XiaoKChen/Work-Normal-Corperation-Altium/README.md

# Work-Normal-Cooperation-Altium
Work-Normal-Cooperation-Altium
