XiaoKChen/Work-Normal-Corperation-Altium/Board/infineon-cy8ckit-062s2-ai-psoc-6-ai-evaluation-board-hardware-pcbdesigndata-en/CY8CKIT-062S2-AI PSoC 6 AI Evaluation Kit PCBA BoM.xlsm

Sheet: Revision History
Revision | Date | Description | Prepared By | Approved By
0.01 | 2023-11-23 | Initial Revision BOM for ordering | MRRS | Vamsi
0.02 | 2023-12-07 | Final Revision BOM for ordering | MRRS | Vamsi
1 | 2023-12-12 | Initial release of Rev01 BoM | MRRS | Vamsi
2 | 2024-02-07 | REV02 design BOM | MRRS | Vamsi
2.1 | 2024-03-04 | REV02 design generated BOM | MRRS | Vamsi
3 | 2024-03-12 | REV03 design BOM | MRRS | Vamsi
 |  |  |  |  | a

Sheet: PCBA BOM
 |  |  |  |  | TITLE | PSoC™ 6 AI Evaluation Board
 |  |  |  |  | PCBA Number & Revision | 121-60699-01 | Rev 03
 |  |  |  |  | Schematics Number & Revision | 630-60699-01 | Rev 03
 |  |  |  |  | DATE | 2024-04-12
 |  |  |  |  | BOM REVISION | Rev 03
 |  |  |  |  | ROHS Compliance | Required
 |  |  |  |  | UL Compliance | Required
# | IFX Part # | Qty | Reference | Value | Description | Manufacturer | Mfr Part # | Alternate Manufacturer | Alternate Mfr Part #
1 | 753-60006-01 | 1 | A2 | 2450AT07A0100T | ANTENNA, CERAMIC CHIP, Single Band, 2.4GHz, SMD | Johanson | 2450AT07A0100T
2 | 510-60777-01 | 33 | C1,C4,C8,C14,C17,C19,C21,C23,C26,C28,C30,C32,C41,C43,C45,C47,C49,C50,C52,C53,C55,C57,C58,C66,C67,C68,C71,C92,C115,C116,C119,C121,C256 | 0.1uF | CAP, CER, 0.1uF, 20%, X5R, 10V, 0201 | Wurth | 885012104002
3 | 510-60422-01 | 4 | C2,C5,C247,C248 | 4.7uF | CAP, CER, 0402, 4.7uF, 20%, 10V, X5R | Murata | GRM155R61A475MEAAD
4 | 510-60877-01 | 5 | C3,C7,C12,C13,C15 | 1uF | CAP, CER, 1UF, 20%, 10V, X5R, 0402 | Wurth | 885012105012
5 | 510-60089-01 | 1 | C6 | 10nF | CAP, CER, 10nF, 10%, X7R, 50V, 0402 | Wurth | 885012205067
6 | 510-60337-01 | 14 | C9,C10,C11,C36,C38,C40,C72,C74,C76,C78,C81,C83,C87,C88 | 10uF | CAP, CER, 10uF, 20%, X5R, 10V, 0402 | Samsung | CL05A106MP8NUB8
7 | 510-61118-01 | 31 | C16,C18,C20,C22,C24,C25,C27,C29,C31,C33,C34,C37,C39,C42,C44,C46,C48,C51,C54,C56,C73,C75,C77,C79,C82,C84,C85,C86,C89,C93,C249 | 1uF | CAP, CER, 1UF, 10V, X5R, 0201 | YAEGO | CC0201MRX5R6BB105
8 | 510-61073-01 | 1 | C35 | 4.7uF | CAP, CER, 4.7µF, ±20%, 6.3V, X5R, 0201 | Murata | GRM035R60J475ME15J
9 | 510-60833-01 | 2 | C60,C61 | 22pF | CAP, CER, 22pF, 5%, NP0, 25V, 0201 | Wurth | 885012004008
10 | 510-60782-01 | 2 | C62,C63 | 10pF | CAP, CER, 10pF, 5%, NP0, 25V, 0201 | Wurth | 885012004004
11 | 510-61137-01 | 1 | C80 | 0.47uF | CAP, CER, 0.47UF, 20%, X5R, 6.3V, 0402 | Wurth | 885012105004
12 | 510-60376-01 | 2 | C99,C245 | 2.2uF | CAP CER 2.2UF 10V X5R 0402 | Wurth | 885012105013
13 | 510-60825-01 | 2 | C246,C254 | 6.8pF | CAP CER 6.8PF 50V C0G/NP0 0402 | Johanson | 500R07S6R8BV4T
14 | 510-60250-01 | 1 | C250 | 1.2pF | CAP, CER, 1.2PF, 8%, NP0, 50V, 0402 | Johanson | 500R07S1R2BV4T
15 | 534-60141-01 | 5 | D1,D2,D3,D11,D12 | 5988A10107F | DIO, LED, 635nm, RED, 0402 | Dialight | 5988A10107F
16 | 530-60314-01 | 2 | D4,D10 | T5V0S5A-7 | DIODE, TVS, 17.3V, 15A, SOD-523 | Diodes Incorporated | T5V0S5A-7
17 | BAS3010B03WE6327HTSA1 | 2 | D5,D6 | BAS3010B03WE6327HTSA1 | DIODE SCHOTTKY 30V 1A SOD323-2 | Infineon | BAS3010B03WE6327HTSA1
18 | 534-60149-01 | 1 | D8 | LTST-C281KGKT | LED, GREEN, CLEAR, 571nm, 2V, 0402 | Lite-On Inc. | LTST-C281KGKT
19 | 530-60165-01 | 1 | D9 | ESD5V0D5-TP | DIO, TVS, UNIDIR, 5V, 18.6V, 174W, SOD-523 | MCC | ESD5V0D5-TP
20 | 520-60305-01 | 10 | FB3,FB4,FB5,FB6,FB7,FB8,FB9,FB10,FB11,FB12 | 600 OHM | IND, FERRITE BEAD, 600 OHM, 0402, 1LN | TDK | MMZ1005B601CT000
21 | 720-60675-01 | 2 | J1,J2 | 629722000214 | CONN, RCPT, USB, TYPE-C, USB2.0, 12POS, TOP MOUNT, RA, SMD | Wurth | 629722000214
22 | 720-60595-01 | 1 | J3 | 620102131822 | CONN, HDR, 1x2POS, SHROUNDED, R/A, 2MM PITCH, SMT | Wurth | 620102131822
23 | 710-60030-01 | 1 | J4 | HDR 5x2 | CONN, HDR, MALE, DUAL, 10POS, 1.27mm, GOLD, STR, SMD | Samtec | FTSH-105-01-L-DV-K-P-TR
24 | 720-60640-01 | 1 | J15 | DF40C-20DP-0.4V(51) | CONN, PLUG, DUAL, 20POS, 0.4mm, SMD, GOLD | Hirose | DF40C-20DP-0.4V(51)
25 | 720-60696-01 | 1 | J16 | 665104131822 | CONN, HEADER, R/A, 4POS, 1MM, SMD | Wurth | 665104131822
26 | 520-60318-01 | 1 | L1 | 2.2uH | IND, FIXED, SHIELDED, 2.2uH, 20%, 1.7A, 0.050 OHM, SMD | Wurth | 74404032022
27 | 520-60187-01 | 1 | L2 | 2.2uH | IND, FIXED, SHIELDED, 2.2uH, 0.5A, 0.18 OHM, 0603 | TDK | MLZ1608N2R2LT000
28 | 520-60183-01 | 1 | L3 | 2.2uH | IND, FIXED, SHIELDED, 2.2uH, 0.7A, 0.34 OHM, 0805 | Wurth | 74479774222
29 | 500-61336-01 | 7 | R1,R2,R15,R26,R55,R62,R63 | 1K | RES, 1K OHM, 1%, 1/20W, 0201 | Yageo | RC0201FR-071KL
30 | 500-61335-01 | 6 | R4,R8,R10,R11,R84,R85 | 10K | RES, 10K OHM, 1%, 1/20W, 0201 | Yageo | RC0201FR-0710KL
31 | 500-61333-01 | 4 | R5,R6,R17,R18 | 5.1K | RES, 5.1K OHM, 5%, 1/20W, 0201 | Yageo | RC0201JR-075K1L
32 | 500-61334-01 | 3 | R7,R101,R102 | 100K | RES, 100K OHM, 1%, 1/20W, 0201 | Yageo | RC0201FR-07100KL
33 | 500-61337-01 | 1 | R14 | 3.01K | RES, 3.01K OHM, 1%, 1/20W, 0201 | Yageo | RC0201FR-073K01L
34 | 500-60979-01 | 9 | R16,R19,R20,R22,R25,R34,R41,R281,R282 | 4.7K | RES, 4.7K OHM, 5%, 1/20W, 0201 | Yageo | RC0201JR-074K7L
35 | 500-61332-01 | 1 | R21 | 560K | RES, 560K OHM, 1%, 1/20W, 0201 | Yageo | RC0201FR-07560KL
36 | 500-61331-01 | 1 | R23 | 90.9K | RES, 90.9K OHM, 1%, 1/20W, 0201 | Yageo | RC0201FR-0790K9L
37 | 500-60585-01 | 14 | R27,R40,R56,R57,R59,R60,R100,R275,R277,R278,R284,R288,R289,R290 | 0 OHM | RES, Fixed, 0 OHM, JUMPER, 1A, 0402 | Yageo | RC0402JR-070RL
38 | 500-61326-01 | 1 | R28 | 49.9K | RES, 49.9K OHM, 1%, 1/20W, 0201 | Yageo | RC0201FR-0749K9L
39 | 500-61327-01 | 3 | R30,R33,R279 | 15K | RES, 15K OHM, 1%, 1/20W, 0201 | Yageo | RC0201FR-0715KL
40 | 500-61325-01 | 3 | R31,R36,R280 | 30K | RES, 30K OHM, 1%, 1/20W, 0201 | Yageo | RC0201FR-0730KL
41 | 500-61328-01 | 2 | R35,R37 | 22 OHM | RES, 22 OHM, 5%, 1/20W, 0201 | Yageo | RC0201JR-0722RL
42 | 500-61330-01 | 1 | R38 | 560 OHM | RES, 560 OHM, 5%, 1/20W, 0201 | Yageo | RC0201JR-07560RL
43 | 500-60037-01 | 3 | R39,R96,R97 | 0 OHM | RES, Fixed, 0 OHM, JUMPER, 1A, 0603 | Panasonic | ERJ-3GEY0R00V
44 | 500-60978-01 | 7 | R42,R43,R44,R45,R46,R47,R50 | 47K | RES, Fixed, 47K, 5%, 1/20W, 0201 | Yageo | RC0201JR-0747KL
45 | 500-60980-01 | 11 | R48,R49,R51,R52,R53,R54,R87,R88,R89,R90,R91 | 33 OHM | RES, Fixed, 33 OHM, 5%, 1/20W, 0201 | Yageo | RC0201JR-0733RP
46 | 500-60684-01 | 16 | R64,R65,R72,R74,R80,R81,R86,R285,R287,R291,R292,R293,R294,R295,R296,R299 | 0 OHM | RES, Fixed, 0 OHM, JUMPER, 0.5A, 0201 | Yageo | RC0201JR-070RL
47 | 500-61324-01 | 2 | R71,R79 | 100 OHM | RES, FIXED, 100 OHM, 5%, 1/20W, 0201 | Yageo | RC0201JR-07100RL
48 | 500-60730-01 | 1 | R83 | 150 OHM | RES, Fixed, 150 OHM, 1%, 1/10W, 0402 | Panasonic | ERJ-2RKF1500X
49 | 770-60161-01 | 3 | SW1,SW2,SW3 | 435171014816 | SW, Tactile Switch SPST-NO, TOP Actuated SMD | Wurth | 435171014816
50 | CY8C624ABZI-S2D44 | 1 | U1 | CY8C624ABZI-S2D44 | IC, CYPRESS, MCU, PSoC 62-S2, Dual Core, 150/100MHz, 1.71V-3.6V, 124-BGA | Cypress | CY8C624ABZI-S2D44
51 | CY8C5868LTI-LP039 | 1 | U2 | CY8C5868LTI-LP039 | IC, CYPRESS, MCU, PSoC 5LP, 32 Bit MCU, 67MHz, 1.8V-5.5V, 68-QFN | Cypress | CY8C5868LTI-LP039
52 | DPS368XTSA1 | 1 | U3 | DPS368XTSA1 | IC, INFINEON, SENSOR, 17.4PSIG, 24BIT, 8VLGA | infineon | DPS368XTSA1
53 | IM72D128V01XTMA1 | 2 | U4,U5 | IM72D128V01XTMA1 | IC, INFINEON, DIGITAL MEMS MICROPHONE, 1.62 to 3.6V, -36dB, SMD | Infineon | IM72D128V01XTMA1
54 | BGT60TR13CE6327XUMA1 | 1 | U6 | BGT60TR13CE6327XUMA1 | IC, INFINEON, Radar Sensor, 60GHz, 1Tx 3Rx Antennas in Package, PG-VF2BGA40-1 | Infineon | BGT60TR13CE6327XUMA1
55 | S25HS512TFANHI010 | 1 | U7 | S25HS512TFANHI010 | IC, INFINEON, QSPI Flash, 1.8V IO, 166Mhz, 512Mb, WSON-8 | infineon | S25HS512TFANHI010
56 | 471-60048-01 | 1 | U8 | BQ24074RGTT | IC, REG, Battery Charger, Single Cell Li-Ion, 1.5A, 16VQFN | TI | BQ24074RGTT
57 | ESD5V3U2U-03F | 2 | U9,U16 | ESD5V3U2U-03F | DIO, INFINEON, ESD Protection, 5.3V, 2CH, +/-20KV, SOT-723 | IFX | ESD5V3U2U-03F
58 | 470-60022-01 | 1 | U11 | RT6150BGQW | IC, REG, BUCK BST, ADJ, 800MA, 10WDFN | Richtek | RT6150BGQW
59 | 540-60028-01 | 1 | U15 | 80 MHz | OSC, 80MHz, 50PPM, 1.6/3.63V, SMD | KYOCERA | KC2016K80.0000C1GE00
60 | 460-60009-01 | 1 | U17 | LBEE5KL1YN-814 | IC, Module, CYW43439, 2.4GHz WLAN + Bluetooth, SMD | Murata | LBEE5KL1YN-814
61 | 415-00031-01 | 1 | U18 | BMI270 | IC, IMU, ACCELEROMETER/GYRO, 6-AXIS, I2C/SPI, 14-LGA | Bosch | BMI270
62 | 415-00032-01 | 1 | U19 | BMM350 | IC, SENSOR, MAGNETOMETER, MAGNETORESISTIVE, 3-AXIS, I2C/I3C, 9-WLCSP | Bosch | BMM350
63 | 471-60050-01 | 1 | U20 | NCP115AMX330TBG | IC, REG, LINEAR, 3.3V, 300mA, 4XDFN | ONSEMI | NCP115AMX330TBG
64 | 471-60051-01 | 1 | U21 | NCP115AMX180TBG | IC, REG, LINEAR, 1.8.V, 300mA, 4XDFN | ONSEMI | NCP115AMX180TBG
65 | 542-60119-01 | 1 | Y1 | 32.768KHz | XTAL, 32.768kHz, 20ppm, 12.5pF, SMD | WURTH | 830065253
66 | 542-60117-01 | 1 | Y2 | 24MHZ | CRYSTAL, 24MHZ, ±10ppm, 10PF, SMD | CTS | 402F2401XIAR
67 | 540-60011-01 | 1 | Y3 | SIT1533AI-H4-DCC-32.768E | OSC, MEMS, 32.768kHz, 20ppm, LVCMOS, SMD | SiTIME | SIT1533AI-H4-DCC-32.768E
ACCESSORIES
68 | 121-60699-01 | 1 | ACC1 | 121-60699-01 | ASSY, PCBA, CY8CKIT-062S2-AI - PSoC6 AI Evluation board | Cypress Approved CM | 121-60699-01
69 | 600-60699-01 | 1 | ACC2 | 600-60699-01 | PCB, BARE, CY8CKIT-062S2-AI - PSoC6 AI Evluation board | Cypress Approved CM | 600-60699-01
70 | 610-60699-01 | 1 | ACC3 | 610-60699-01 | DRW, FABRICATION DRAWING, CY8CKIT-062S2-AI - PSoC6 AI Evluation board | -NA- | 610-60699-01
71 | 620-60699-01 | 1 | ACC4 | 620-60699-01 | DRW, ASSEMBLY DRAWING, CY8CKIT-062S2-AI - PSoC6 AI Evluation board | -NA- | 620-60699-01
72 | 630-60699-01 | 1 | ACC5 | 630-60699-01 | DRW, SCHEMATIC DRAWING, CY8CKIT-062S2-AI - PSoC6 AI Evluation board | -NA- | 630-60699-01
No Load
73 | 510-60512-02 | 1 | C253 | 150pF | CAP, CER, 150pF, 5%, C0G/NP0, 50V, 0402 | Samsung | CL05C151JB5NNNC
74 | 510-60825-01 | 1 | C255 | 6.8pF | CAP CER 6.8PF 50V C0G/NP0 0402 | Johanson | 500R07S6R8BV4T
75 | 720-60585-01 | 1 | J5 | A-1JB | CONN, UMC, JACK, STR, 50 OHM, SMD | Amphenol | A-1JB
76 | 710-60054-01 | 1 | J17 | PRPC006SFAN-RC | CONN, HEADER, VERT, 6POS, 2.54MM, TH | Sullins | PRPC006SFAN-RC
77 | 710-60142-01 | 1 | J18 | PRPC009SFAN-RC | CONN, HEADER, VERT, 9POS, 2.54MM, TH | Sullins | PRPC009SFAN-RC
78 | 520-60020-01 | 1 | L4 | 6.8nH | IND, FIXED, UNSHIELDED, 6.8nH, 0.25A, 0.32 OHM, 0402 | Johanson | L-07C6N8JV6T
79 | 500-61335-01 | 3 | R3,R9,R12 | 10K | RES, 10K OHM, 1%, 1/20W, 0201 | Yageo | RC0201FR-0710KL
80 | 500-61080-01 | 1 | R13 | 10K | RES, Fixed, 10K, 1%, 1/16W, 0402 | Yageo | RT0402FRE0710KL
81 | 500-60979-01 | 1 | R24 | 4.7K | RES, 4.7K OHM, 5%, 1/20W, 0201 | Yageo | RC0201JR-074K7L
82 | 500-61326-01 | 1 | R29 | 49.9K | RES, 49.9K OHM, 1%, 1/20W, 0201 | Yageo | RC0201FR-0749K9L
83 | 500-60978-01 | 1 | R58 | 47K | RES, Fixed, 47K, 5%, 1/20W, 0201 | Yageo | RC0201JR-0747KL
84 | 500-61334-01 | 1 | R66 | 100K | RES, 100K OHM, 1%, 1/20W, 0201 | Yageo | RC0201FR-07100KL
85 | 500-60684-01 | 4 | R73,R82,R283,R286 | 0 OHM | RES, Fixed, 0 OHM, JUMPER, 0.5A, 0201 | Yageo | RC0201JR-070RL
86 | 500-61325-01 | 2 | R297,R298 | 30K | RES, 30K OHM, 1%, 1/20W, 0201 | Yageo | RC0201FR-0730KL
87 | NA | 26 | TP1,TP2,TP3,TP4,TP5,TP6,TP7,TP8,TP9,TP10,TP11,TP12,TP16,TP17,TP19,TP23,TP24,TP26,TP27,TP28,TP29,TP30,TP31,TP32,TP33,TP34 | TP_SMD | TestPoint, PCB, Circle, 1mm, SMD | NA | NA
 |  |  |  |  |  |  |  |  |  | DNI
 |  |  |  |  |  |  |  |  |  | DNI
 |  |  |  |  |  |  |  |  |  | DNI
 |  |  |  |  |  |  |  |  |  | DNI
 |  |  |  |  |  |  |  |  |  | DNI
 |  |  |  |  |  |  |  |  |  | DNI
 |  |  |  |  |  |  |  |  |  | DNI
 |  |  |  |  |  |  |  |  |  | DNI
 |  |  |  |  |  |  |  |  |  | DNI
 |  |  |  |  |  |  |  |  |  | DNI
 |  |  |  |  |  |  |  |  |  | DNI
 |  |  |  |  |  |  |  |  |  | DNI
 |  |  |  |  |  |  |  |  |  | DNI
 |  |  |  |  |  |  |  |  |  | DNI
 |  |  |  |  |  |  |  |  |  | DNI
