XiaoKChen/Work-Normal-Corperation-Altium/Components/LIB_ADS7951SRGER/ADS7951SRGER/3D/ADS7951SRGER.stp

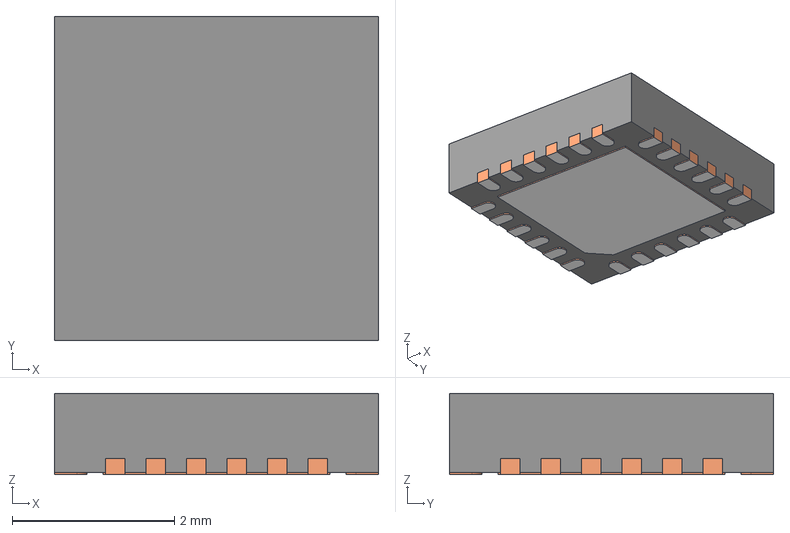
[picture p1: CAD file, 2025-12-14]
Components/LIB_ADS7951SRGER/ADS7951SRGER/3D/ADS7951SRGER.stp
4.00 x 4.00 x 1.00 mm
BODY-QFN
FRAME-RGE0024F
PIN1-ID
