XiaoKChen/Work-Normal-Corperation-Altium/Components/LIB_APHHS1005LQBC_D-V/APHHS1005LQBC_D-V/3D/APHHS1005LQBC_D-V.stp

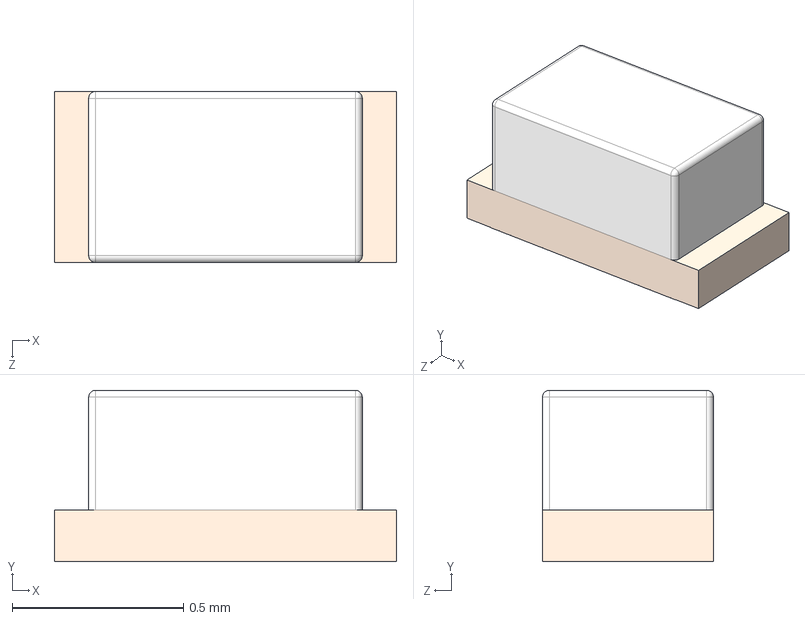
[picture p2: CAD file, 2025-12-14]
Components/LIB_APHHS1005LQBC_D-V/APHHS1005LQBC_D-V/3D/APHHS1005LQBC_D-V.stp
1.00 x 0.501 x 0.5 mm
