XiaoKChen/Work-Normal-Corperation-Altium/Components/LIB_CY8C5868LTI-LP039/CY8C5868LTI-LP039/3D/CY8C5868LTI-LP039.stp

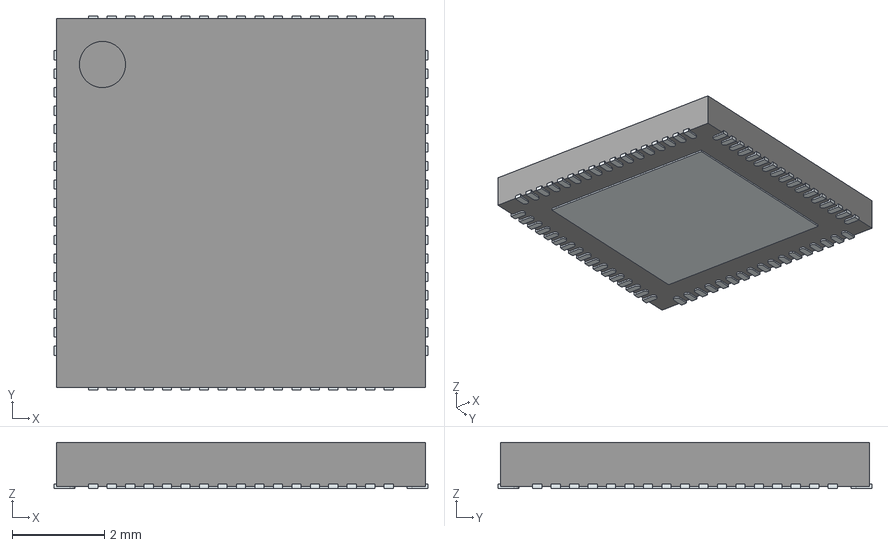
[picture p3: CAD file, 2025-12-14]
Components/LIB_CY8C5868LTI-LP039/CY8C5868LTI-LP039/3D/CY8C5868LTI-LP039.stp
8.10 x 8.10 x 1.00 mm
ThermalPin
PinsArrayLR
PinsArrayTB
