XiaoKChen/Work-Normal-Corperation-Altium/Components/LIB_ERA-2VEB1002X/ERA-2VEB1002X/3D/ERA-2VEB1002X.stp

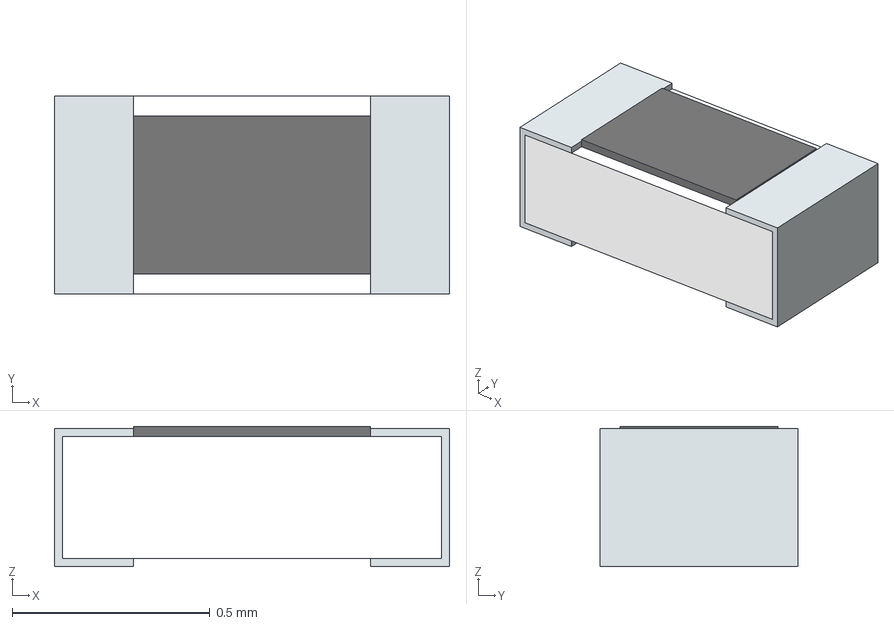
[picture p4: CAD file, 2025-12-14]
Components/LIB_ERA-2VEB1002X/ERA-2VEB1002X/3D/ERA-2VEB1002X.stp
1.00 x 0.5 x 0.355 mm
solidBody
Terminal
solidTop
