XiaoKChen/Work-Normal-Corperation-Altium/Components/LIB_ESD2CAN24DBZRQ1/ESD2CAN24DBZRQ1/3D/ESD2CAN24DBZRQ1.stp

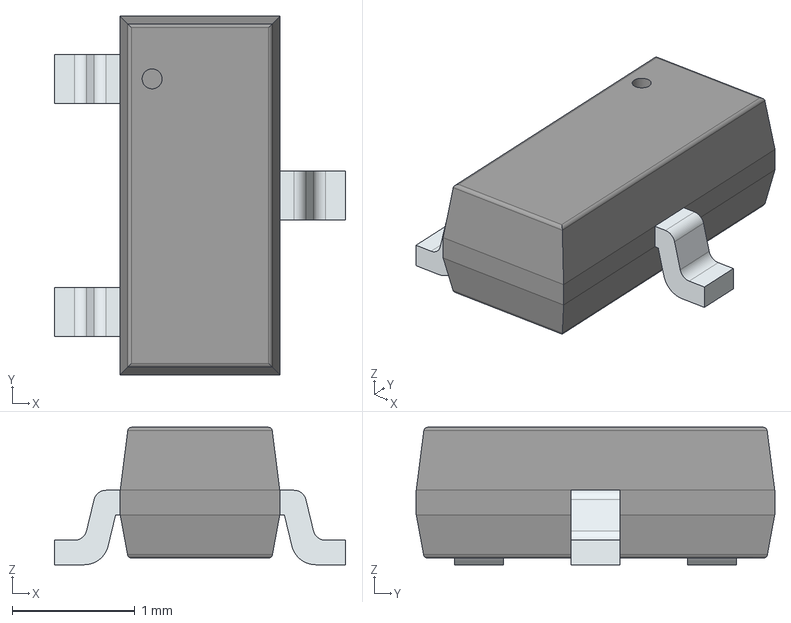
[picture p5: CAD file, 2025-12-14]
Components/LIB_ESD2CAN24DBZRQ1/ESD2CAN24DBZRQ1/3D/ESD2CAN24DBZRQ1.stp
2.37 x 2.92 x 1.12 mm
PinsArrayL
FilletPinR
