XiaoKChen/Work-Normal-Corperation-Altium/Components/LIB_FTSH-105-01-L-DV-K-P-TR/FTSH-105-01-L-DV-K-P-TR/3D/FTSH-105-01-L-DV-K-P-TR.stp

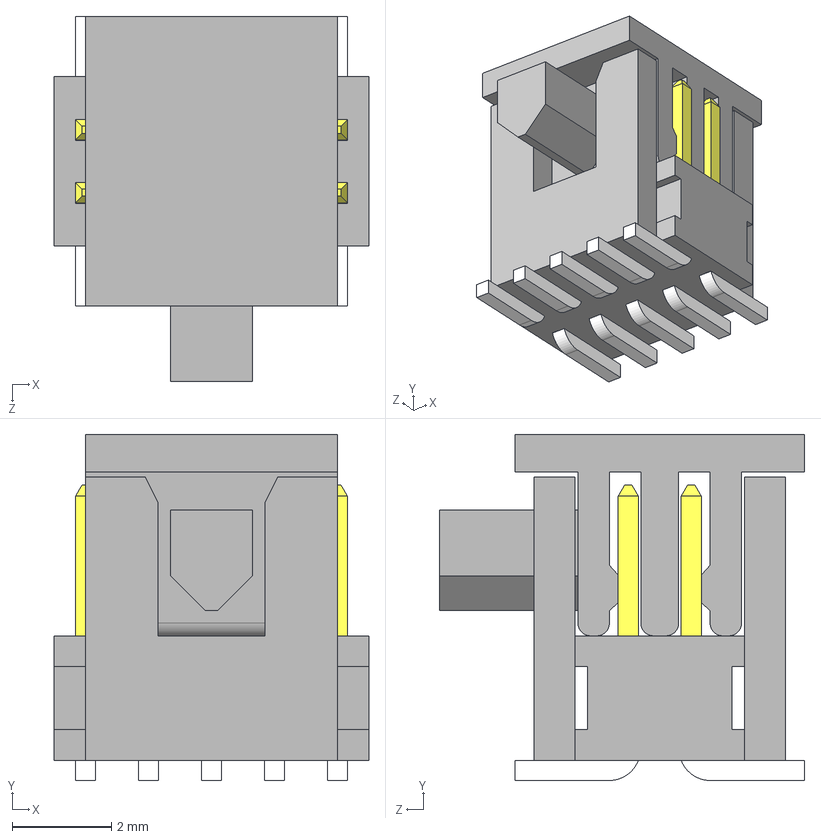
[picture p6: CAD file, 2025-12-14]
Components/LIB_FTSH-105-01-L-DV-K-P-TR/FTSH-105-01-L-DV-K-P-TR/3D/FTSH-105-01-L-DV-K-P-TR.stp
6.35 x 6.98 x 7.37 mm
FTSH-105-01-L-DV-K-P-TR_pp_pad
FTSH-105-01-L-DV-K-P-TR_pins2
FTSH-105-01-L-DV-K-P-TR_pins1
FTSH-105-01-L-DV-K-P-TR_body
