XiaoKChen/Work-Normal-Corperation-Altium/Components/LIB_R7FA4M1AB3CFM#AA0/R7FA4M1AB3CFM#AA0/3D/R7FA4M1AB3CFM#AA0.stp

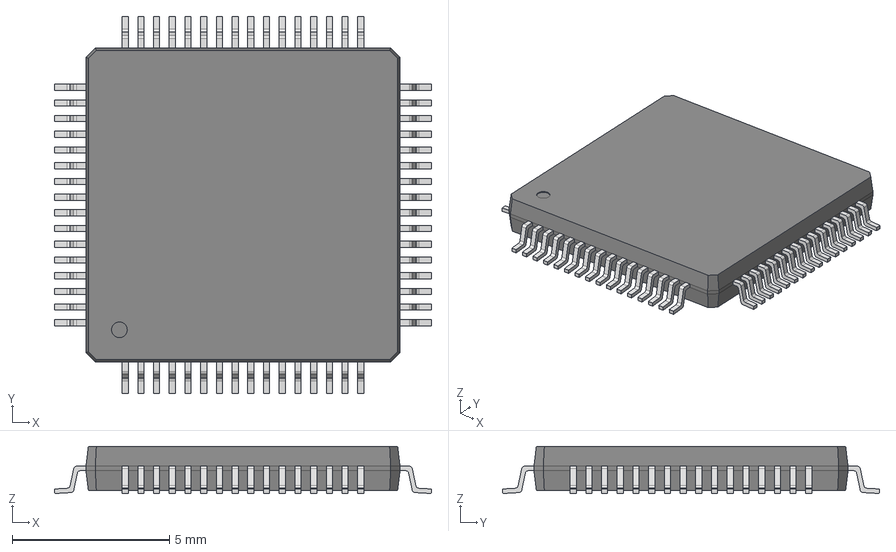
[picture p7: CAD file, 2025-12-14]
Components/LIB_R7FA4M1AB3CFM#AA0/R7FA4M1AB3CFM#AA0/3D/R7FA4M1AB3CFM#AA0.stp
12.0 x 12.0 x 1.50 mm
