XiaoKChen/Work-Normal-Corperation-Altium/Components/LIB_T5V0S5A-7/T5V0S5A-7/3D/T5V0S5A-7.stp

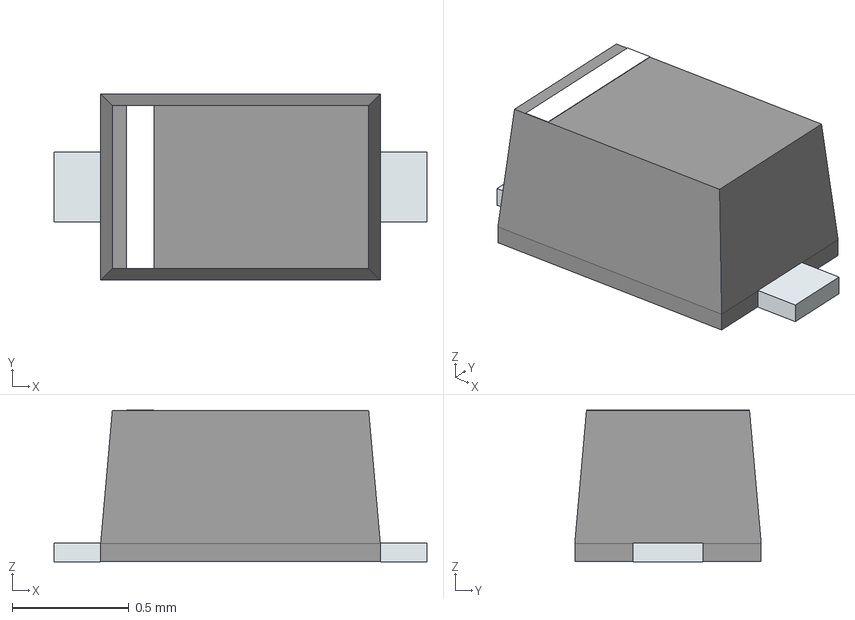
[picture p8: CAD file, 2025-12-14]
Components/LIB_T5V0S5A-7/T5V0S5A-7/3D/T5V0S5A-7.stp
1.60 x 0.8 x 0.65 mm
PinKIdent
PinK
PinA
