XiaoKChen/Work-Normal-Corperation-Altium/Components/LIB_TCAN332DR/TCAN332DR/3D/TCAN332DR.stp

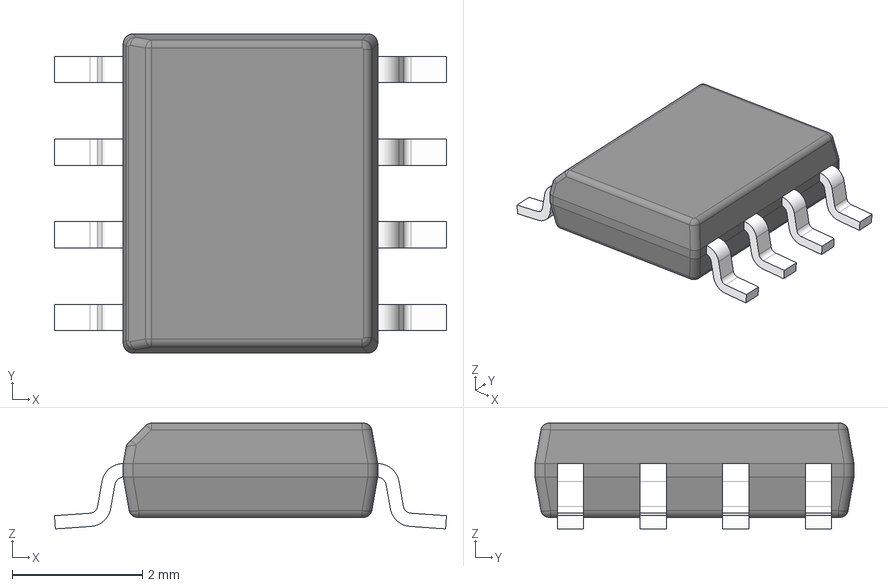
[picture p9: CAD file, 2025-12-14]
Components/LIB_TCAN332DR/TCAN332DR/3D/TCAN332DR.stp
6.02 x 4.90 x 1.63 mm
BODY-SO
LEAD-D0008A x 8
