XiaoKChen/Work-Normal-Corperation-Altium/Components/LIB_20021121-00010C4LF/20021121-00010C4LF/3D/20021121-00010C4LF.stp

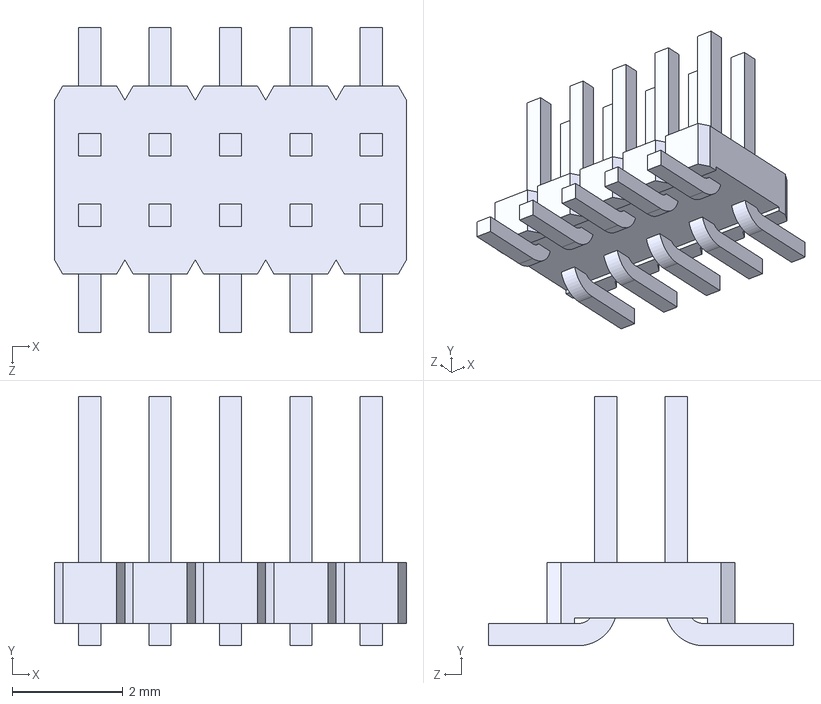
[picture p10: CAD file, 2025-12-14]
Components/LIB_20021121-00010C4LF/20021121-00010C4LF/3D/20021121-00010C4LF.stp
6.35 x 4.50 x 5.50 mm
