XiaoKChen/Work-Normal-Corperation-Altium/(list of files, cad)

Other CAD files:
Components/LIB_20021121-00010C4LF/20021121-00010C4LF/Allegro/2002112100010c4lf.psm
Components/LIB_20021121-00010C4LF/20021121-00010C4LF/DEHDL/20021121_00010c4lf/chips/chips.prt
Components/LIB_ADS7951SRGER/ADS7951SRGER/Allegro/qfn50p400x400x100-25n.psm
Components/LIB_ADS7951SRGER/ADS7951SRGER/DEHDL/ads7951srger/chips/chips.prt
Components/LIB_APHHS1005LQBC_D-V/APHHS1005LQBC_D-V/Allegro/aphhs1005lqbcdv.psm
Components/LIB_APHHS1005LQBC_D-V/APHHS1005LQBC_D-V/DEHDL/aphhs1005lqbc_d_v/chips/chips.prt
Components/LIB_CY8C5868LTI-LP039/CY8C5868LTI-LP039/Allegro/qfn40p800x800x100-69n-d.psm
Components/LIB_CY8C5868LTI-LP039/CY8C5868LTI-LP039/DEHDL/cy8c5868lti_lp039/chips/chips.prt
Components/LIB_ERA-2VEB1002X/ERA-2VEB1002X/Allegro/era2v__0402_.psm
Components/LIB_ERA-2VEB1002X/ERA-2VEB1002X/DEHDL/era_2veb1002x/chips/chips.prt
Components/LIB_ESD2CAN24DBZRQ1/ESD2CAN24DBZRQ1/Allegro/sot95p237x112-3n.psm
Components/LIB_ESD2CAN24DBZRQ1/ESD2CAN24DBZRQ1/DEHDL/esd2can24dbzrq1/chips/chips.prt
Components/LIB_FTSH-105-01-L-DV-K-P-TR/FTSH-105-01-L-DV-K-P-TR/Allegro/ftsh-105-xx-yyy-dv-k-p-tr.psm
Components/LIB_FTSH-105-01-L-DV-K-P-TR/FTSH-105-01-L-DV-K-P-TR/DEHDL/ftsh_105_01_l_dv_k_p_tr/chips/chips.prt
Components/LIB_R7FA4M1AB3CFM#AA0/R7FA4M1AB3CFM#AA0/Allegro/qfp50p1200x1200x170-64n.psm
Components/LIB_R7FA4M1AB3CFM#AA0/R7FA4M1AB3CFM#AA0/DEHDL/r7fa4m1ab3cfm#aa0/chips/chips.prt
Components/LIB_T5V0S5A-7/T5V0S5A-7/Allegro/sodfl1608x65n.psm
Components/LIB_T5V0S5A-7/T5V0S5A-7/DEHDL/t5v0s5a_7/chips/chips.prt
Components/LIB_TCAN332DR/TCAN332DR/Allegro/soic127p600x175-8n.psm
Components/LIB_TCAN332DR/TCAN332DR/DEHDL/tcan332dr/chips/chips.prt
Components/LIB_TPS62086RLTR/TPS62086RLTR/Allegro/tps62086rltr.psm
Components/LIB_TPS62086RLTR/TPS62086RLTR/DEHDL/tps62086rltr/chips/chips.prt
