XiaoKChen/Work-Normal-Corperation-Altium/Board/infineon-cy8ckit-062s2-ai-psoc-6-ai-evaluation-board-hardware-pcbdesigndata-en/CY8CKIT-062S2-AI PSoC 6 AI Evaluation Board Fabrication Drawing.pdf

D

### NOTES: UNLESS OTHERWISE SPECIFIED

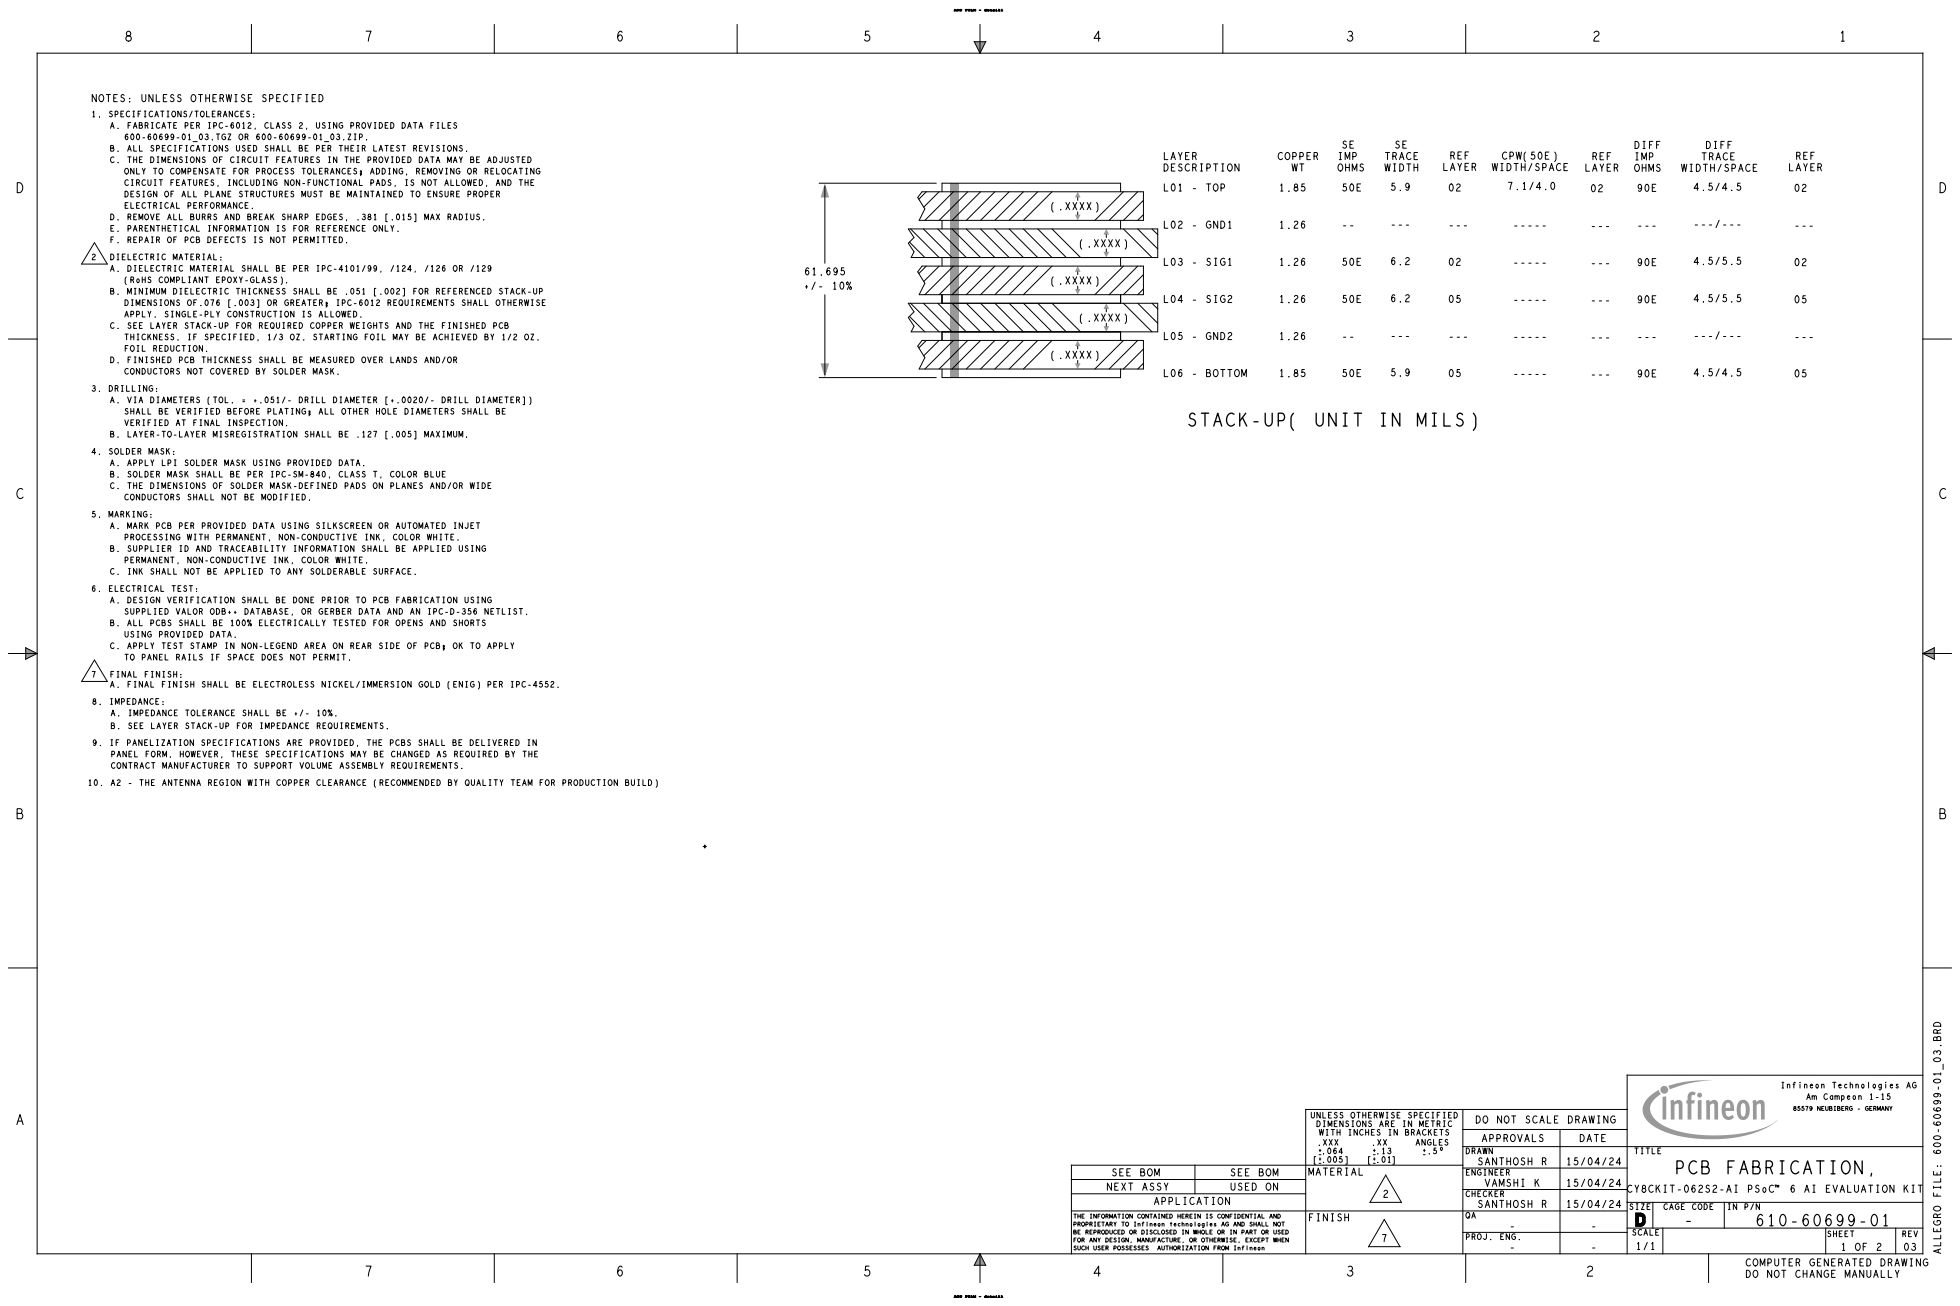
[picture p11: page 1]
ART FILM - detail1; FINAL FINISH:; DIELECTRIC MATERIAL:; PANEL FORM.; HOWEVER, THESE SPECIFICATIONS MAY BE CHANGED AS REQUIRED BY THE; (.XXXX); SUCH USER POSSESSES; AUTHORIZATION FROM Infineon; THE INFORMATION CONTAINED; HEREIN IS CONFIDENTIAL AND; L06 - BOTTOM; L05 - GND2; L04 - SIG2; L03 - SIG1; L02 - GND1; L01 - TOP; DESCRIPTION; LAYER; COPPER WT; UNLESS OTHERWISE SPECIFIED; .XXX; WITH INCHES IN BRACKETS; DIMENSIONS ARE IN METRIC; OHMS; IMP; WIDTH; TRACE; ANGLES; REF; APPROVALS; VAMSHI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

1. SPECIFICATIONS/TOLERANCES:
A. FABRICATE PER IPC-6012, CLASS 2, USING PROVIDED DATA FILES
600-60699-01_03.TGZ OR 600-60699-01_03.ZIP.
B. ALL SPECIFICATIONS USED SHALL BE PER THEIR LATEST REVISIONS.
C. THE DIMENSIONS OF CIRCUIT FEATURES IN THE PROVIDED DATA MAY BE ADJUSTED
ONLY TO COMPENSATE FOR PROCESS TOLERANCES; ADDING, REMOVING OR RELOCATING
CIRCUIT FEATURES, INCLUDING NON-FUNCTIONAL PADS, IS NOT ALLOWED, AND THE
DESIGN OF ALL PLANE STRUCTURES MUST BE MAINTAINED TO ENSURE PROPER
ELECTRICAL PERFORMANCE.
D. REMOVE ALL BURRS AND BREAK SHARP EDGES, .381 [.015] MAX RADIUS.

E. PARENTHETICAL INFORMATION IS FOR REFERENCE ONLY.
F. REPAIR OF PCB DEFECTS IS NOT PERMITTED.

A. DIELECTRIC MATERIAL SHALL BE PER IPC-4101/99, /124, /126 OR /129
(RoHS COMPLIANT EPOXY-GLASS).
B. MINIMUM DIELECTRIC THICKNESS SHALL BE .051 [.002] FOR REFERENCED STACK-UP
DIMENSIONS OF.076 [.003] OR GREATER; IPC-6012 REQUIREMENTS SHALL OTHERWISE
APPLY. SINGLE-PLY CONSTRUCTION IS ALLOWED.
C. SEE LAYER STACK-UP FOR REQUIRED COPPER WEIGHTS AND THE FINISHED PCB

THICKNESS. IF SPECIFIED, 1/3 OZ. STARTING FOIL MAY BE ACHIEVED BY 1/2 OZ.
FOIL REDUCTION.
D. FINISHED PCB THICKNESS SHALL BE MEASURED OVER LANDS AND/OR
CONDUCTORS NOT COVERED BY SOLDER MASK.

3. DRILLING:
A. VIA DIAMETERS (TOL. = +.051/- DRILL DIAMETER [+.0020/- DRILL DIAMETER])
SHALL BE VERIFIED BEFORE PLATING; ALL OTHER HOLE DIAMETERS SHALL BE
VERIFIED AT FINAL INSPECTION.
B. LAYER-TO-LAYER MISREGISTRATION SHALL BE .127 [.005] MAXIMUM.

STACK-UP( UNIT IN MILS)

4. SOLDER MASK:
A. APPLY LPI SOLDER MASK USING PROVIDED DATA.
B. SOLDER MASK SHALL BE PER IPC-SM-840, CLASS T, COLOR BLUE
C. THE DIMENSIONS OF SOLDER MASK-DEFINED PADS ON PLANES AND/OR WIDE
CONDUCTORS SHALL NOT BE MODIFIED.

5. MARKING:
A. MARK PCB PER PROVIDED DATA USING SILKSCREEN OR AUTOMATED INJET
PROCESSING WITH PERMANENT, NON-CONDUCTIVE INK, COLOR WHITE.
B. SUPPLIER ID AND TRACEABILITY INFORMATION SHALL BE APPLIED USING
PERMANENT, NON-CONDUCTIVE INK, COLOR WHITE.
C. INK SHALL NOT BE APPLIED TO ANY SOLDERABLE SURFACE.

6. ELECTRICAL TEST:
A. DESIGN VERIFICATION SHALL BE DONE PRIOR TO PCB FABRICATION USING
SUPPLIED VALOR ODB++ DATABASE, OR GERBER DATA AND AN IPC-D-356 NETLIST.
B. ALL PCBS SHALL BE 100% ELECTRICALLY TESTED FOR OPENS AND SHORTS
USING PROVIDED DATA.
C. APPLY TEST STAMP IN NON-LEGEND AREA ON REAR SIDE OF PCB; OK TO APPLY
TO PANEL RAILS IF SPACE DOES NOT PERMIT.

A. FINAL FINISH SHALL BE ELECTROLESS NICKEL/IMMERSION GOLD (ENIG) PER IPC-4552.

8. IMPEDANCE:
A. IMPEDANCE TOLERANCE SHALL BE +/- 10%.

B. SEE LAYER STACK-UP FOR IMPEDANCE REQUIREMENTS.

9. IF PANELIZATION SPECIFICATIONS ARE PROVIDED, THE PCBS SHALL BE DELIVERED IN
CONTRACT MANUFACTURER TO SUPPORT VOLUME ASSEMBLY REQUIREMENTS.

10. A2 - THE ANTENNA REGION WITH COPPER CLEARANCE (RECOMMENDED BY QUALITY TEAM FOR PRODUCTION BUILD)

ALLEGRO FILE: 600-60699-01_03.BRD

Infineon Technologies AG

DO NOT SCALE DRAWING

DRAWN SANTHOSH R | 15/04/24 | TITLE PCB FABRICATION,

SEE BOM | SEE BOM | MATERIAL | | 2
NEXT ASSY | | USED ON

ENGINEER | 15/04/24

CHECKER SANTHOSH R | 15/04/24

APPLICATION

SIZE | CAGE CODE - | IN P/N | 610-60699-01

PROPRIETARY TO Infineon technologies AG AND SHALL NOT BE REPRODUCED OR DISCLOSED IN WHOLE OR IN PART OR USED FOR ANY DESIGN, MANUFACTURE, OR OTHERWISE, EXCEPT WHEN | FINISH 7 | QA - | -

SCALE 1/1 | SHEET | REV 03

PROJ. ENG. - | -

COMPUTER GENERATED DRAWING
DO NOT CHANGE MANUALLY

D

8

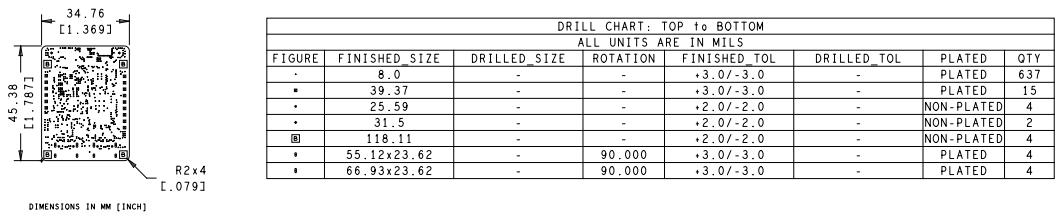
[picture p12: page 2]
ART FILM - detail2; FIGURE; FINISHED_SIZE; DRILLED_SIZE; FINISHED_TOL; THE INFORMATION CONTAINED; HEREIN IS CONFIDENTIAL AND; DRILLED_TOL; NON-PLATED; PLATED; QTY; SCALE; SIZE; CAGE CODE -; SHEET; REV

DRILL CHART: TOP to BOTTOM
ALL UNITS ARE IN MILS
ROTATION

DIMENSIONS IN MM [INCH]

ALLEGRO FILE: 600-60699-01_03.BRD

PROPRIETARY TO Infineon technologies AG AND SHALL NOT

BE REPRODUCED OR DISCLOSED IN WHOLE OR IN PART OR USED

FOR ANY DESIGN, MANUFACTURE, OR OTHERWISE, EXCEPT WHEN

SUCH USER POSSESSES DIRECT, WRITTEN AUTHORIZATION.

COMPUTER GENERATED DRAWING
DO NOT CHANGE MANUALLY
