XiaoKChen/Work-Normal-Corperation-Altium/Board/infineon-cy8ckit-062s2-ai-psoc-6-ai-evaluation-board-hardware-pcbdesigndata-en/CY8CKIT-062S2-AI PSoC 6 AI Evaluation Board Schematic.pdf

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
# CY8CKIT-062S2-AI PSoC™ 6 AI Evaluation Board

PAGE | DESCRIPTION

## 01 Title, Table of Contents & Drawing Numbers

| Function Block Diagram

# CONTENTS

## PCBA

## PCB

## FAB DRW

# Drawing Numbers

02
03
04
05

## ASSY DRW

## SCH DRW

07

06

## Revision History

08

## PSoC™ 6 Power

## PSoC™ 6 Signals

## Power Block Diagram

## USB and Battery Power Supply

## On-board Peripherals09

10
11
12
13
14

## Regulated Voltage Supply

## KitProg3 Interface

## Sensors and Accessories

## QSPI Memory and RADAR Interface

## WiFi / BLE Module Interface

## Addon board interface

## SCH Title :

Size | Document Number | Rev
Date: | Sheet | of

## Page Title:

Drawn By | Approved By

The information given in this document shall in no event be regarded as a guarantee of conditions or characteristics. With respect to any examples or hints given herein, any typical values stated herein and/or any information regarding the application of the device, Infineon Technologies hereby disclaims any and all warranties and liabilities of any kind, including without limitation, warranties of non-infringement of intellectual property rights of any third party.

Legal Disclaimer :

630-60699-01 | 03

## PSoC™ 6 AI Evaluation Board

A4

Monday, March 11, 2024 | 1 | 14

## Title Page

Vamsi | Ronak

## SCH Title :

The information given in this document shall in no event be regarded as a guarantee of conditions or characteristics. With respect to any

Legal Disclaimer :

## PSoC™ 6 AI Evaluation Board

Monday, March 11, 2024 | 1 | 14

## Title Page

## SCH Title :

The information given in this document shall in no event be regarded as a guarantee of conditions or characteristics. With respect to any

Legal Disclaimer :

## PSoC™ 6 AI Evaluation Board

Monday, March 11, 2024 | 1 | 14

## Title Page

600-60699-01

121-60699-01

610-60699-01
620-60699-01
630-60699-01

D D

C C

B B

A A

## No-Load

## Non-IFX parts

## Microcontroller

## Legend

## Sensors

## Power

## Security

## Connectivity

## Memory

# Functional Block Diagram

## PSoCTM 62S2 MCU

## PSoCTM 5LP MCU (KitProg3)

## USB Type-C (KitProg3 USB)

## Mode Switch

## Status LED

### SWD

### UART

I2C

## User Button

## User LED’s

x2

## SWD/JTAG Header

## QSPI Memory

(S70FL01GSDSBHMC10)

## Digital MEMS Microphone

(I M72D128V01XTMA1) x 2

## Pressure Sensor

(DPS368)

## RADAR Sensor

(BGT60TR13CE6327XUMA1)

## 6-axis IMU

(BMI-270)

## WiFi BT/BLE Combo

(LBEE5KL1YN)

## 3-axis Magnetometer

(BMM-350)

## USB Type-C (PSoCTM 6 deviceUSB)

I2C

I2C

### QSPI

PDM-PCM

### SPI

I2C

### SDIO

## IO expansion headers

### QW IIC Conn ect or

### IO’s conn ect or

## SCH Title :

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

Legal Disclaimer :

## PSoC™ 6 AI Evaluation Board

Wednesday, April 03, 2024 | 2 | 14

## Functional Block Diagram

## SCH Title :

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

Legal Disclaimer :

## PSoC™ 6 AI Evaluation Board

Wednesday, April 03, 2024 | 2 | 14

## Functional Block Diagram

## SCH Title :

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

Legal Disclaimer :

## PSoC™ 6 AI Evaluation Board

Wednesday, April 03, 2024 | 2 | 14

## Functional Block Diagram

D D

C C

B B

A A

## No-Load

## Non-IFX parts

## Microcontroller

## Legend

## Sensors

## Power

## Security

## Connectivity

## Memory

# Power Block Diagram

## USB Type-C (KitProg3 USB)

## USB Type-C (PSoCTM 6 deviceUSB)

## Power Or’ing

## Li-ion Battery Connector

## 3.3V Voltage Regulator

## Power path controller

&

## Battery Charger

## 1.8V Voltage Regulator

## Buck – Boost Converter

3.6V – 4.4V

4.8V

3.6V – 4.2V

5V

5V

3.6V

3.6V

3.3V

3.6V

1.8V

## PSoCTM 62S2 MCU

## PSoCTM 5LP MCU (KitProg3)

3.3V

1.8V

5V | QSPI Memory (S70FL01GSDSBHMC10)

## Digital MEMS Microphone

(I M72D128V01XTMA1) x 2

## Pressure Sensor

(DPS368)

## RADAR Sensor

(BGT60TR13CE6327XUMA1)

## 6-axis IMU

(BMI-270)

## WiFi BT/BLE Combo

(LBEE5KL1YN)

## 3-axis Magnetometer

(BMM-350)

3.3V

3.6V

1.8V

3.3V

3.3V

3.3V

1.8V

3.3V

3.3V

## SCH Title :

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

Legal Disclaimer :

## PSoC™ 6 AI Evaluation Board

Friday, April 12, 2024 | 3 | 14

## Power Block Diagram

## SCH Title :

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

Legal Disclaimer :

## PSoC™ 6 AI Evaluation Board

Friday, April 12, 2024 | 3 | 14

## Power Block Diagram

## SCH Title :

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

Legal Disclaimer :

## PSoC™ 6 AI Evaluation Board

Friday, April 12, 2024 | 3 | 14

## Power Block Diagram

## KitProg3 USB Interface and Power Supply

## Li-ion Battery Charger and Power path

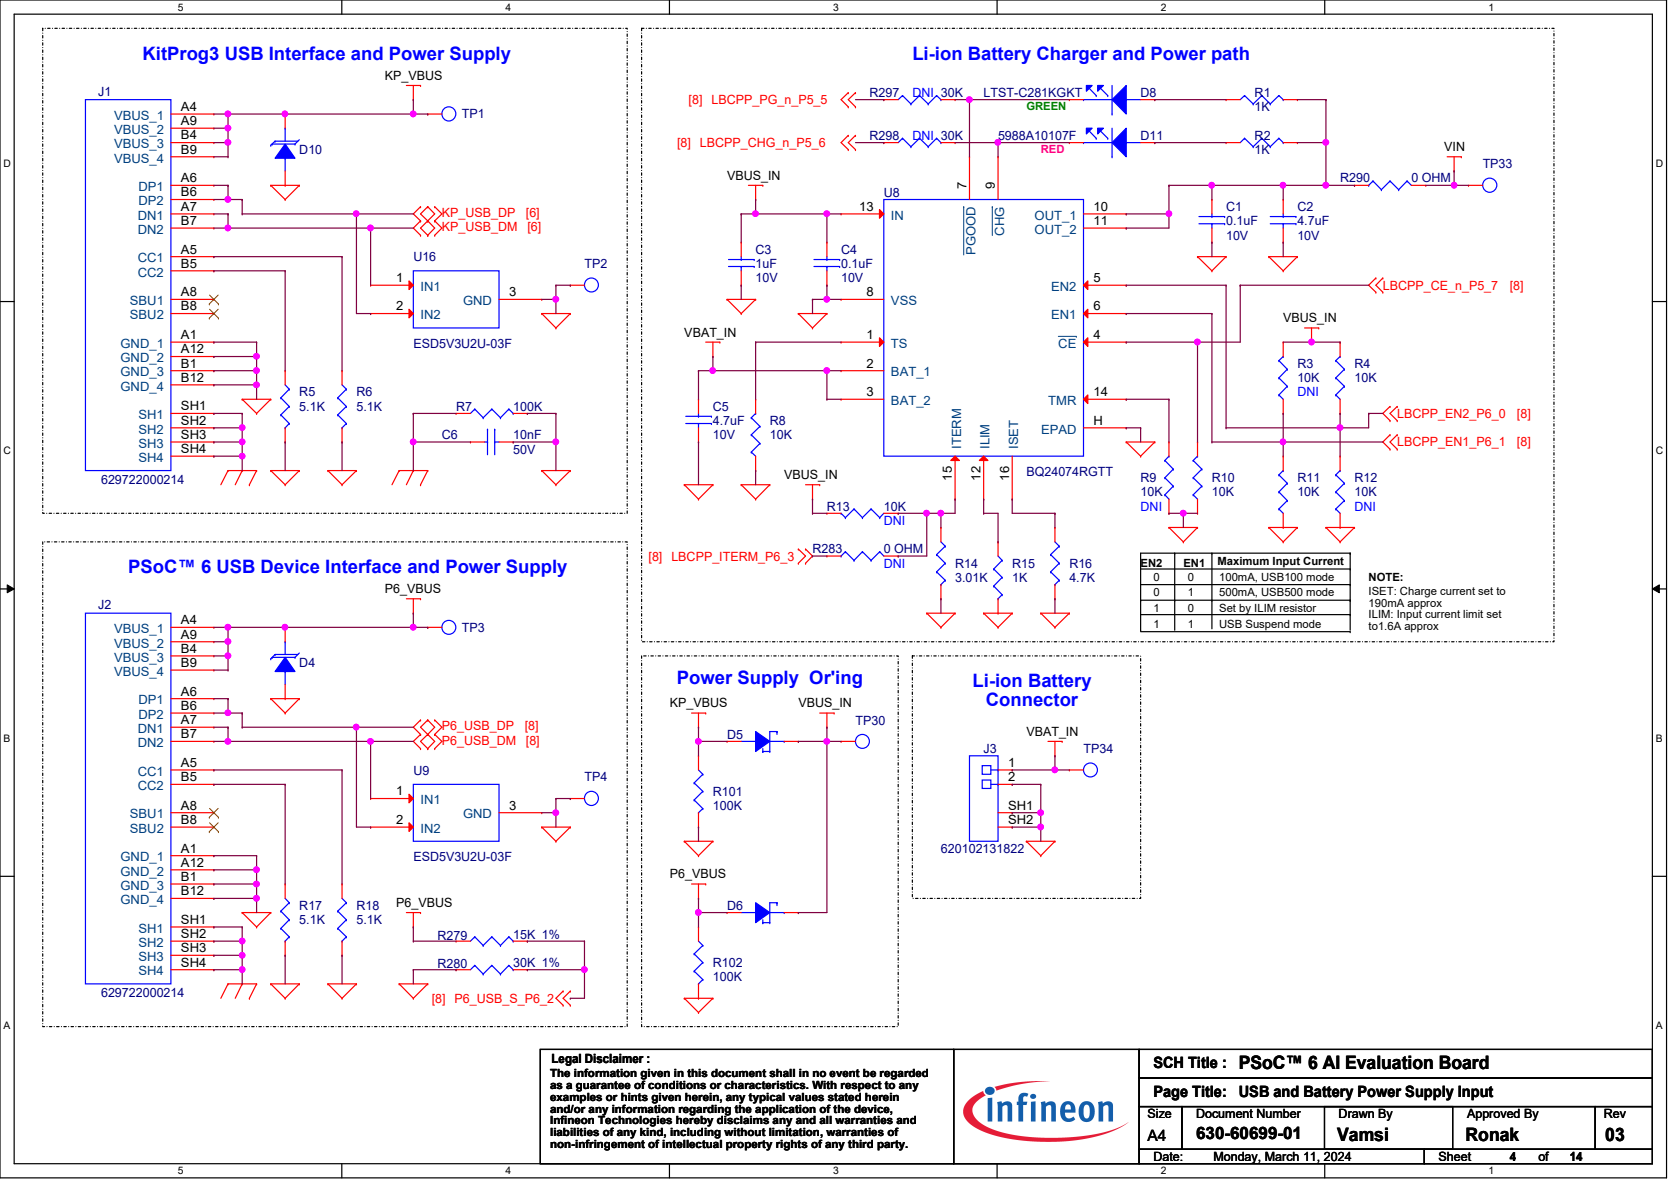
[picture p13: page 4]

PSoC™ 6 USB Device Interface and Power Supply

EN1EN2 | Maximum Input Current
0 | 0 | 100mA, USB100 mode
0 | 1 | 500mA, USB500 mode
1 | 0 | Set by ILIM resistor
1 | 1 | USB Suspend mode

NOTE:
ISET: Charge current set to
190mA approx
ILIM: Input current limit set
to1.6A approx

Power Supply Or'ing

Legal Disclaimer :
The information given in this document shall in no event be regarded
as a guarantee of conditions or characteristics. With respect to any

PSoC™ 6 AI Evaluation Board

USB and Battery Power Supply Input

## 3.3V Power supply

## Buck-Boost Power supply

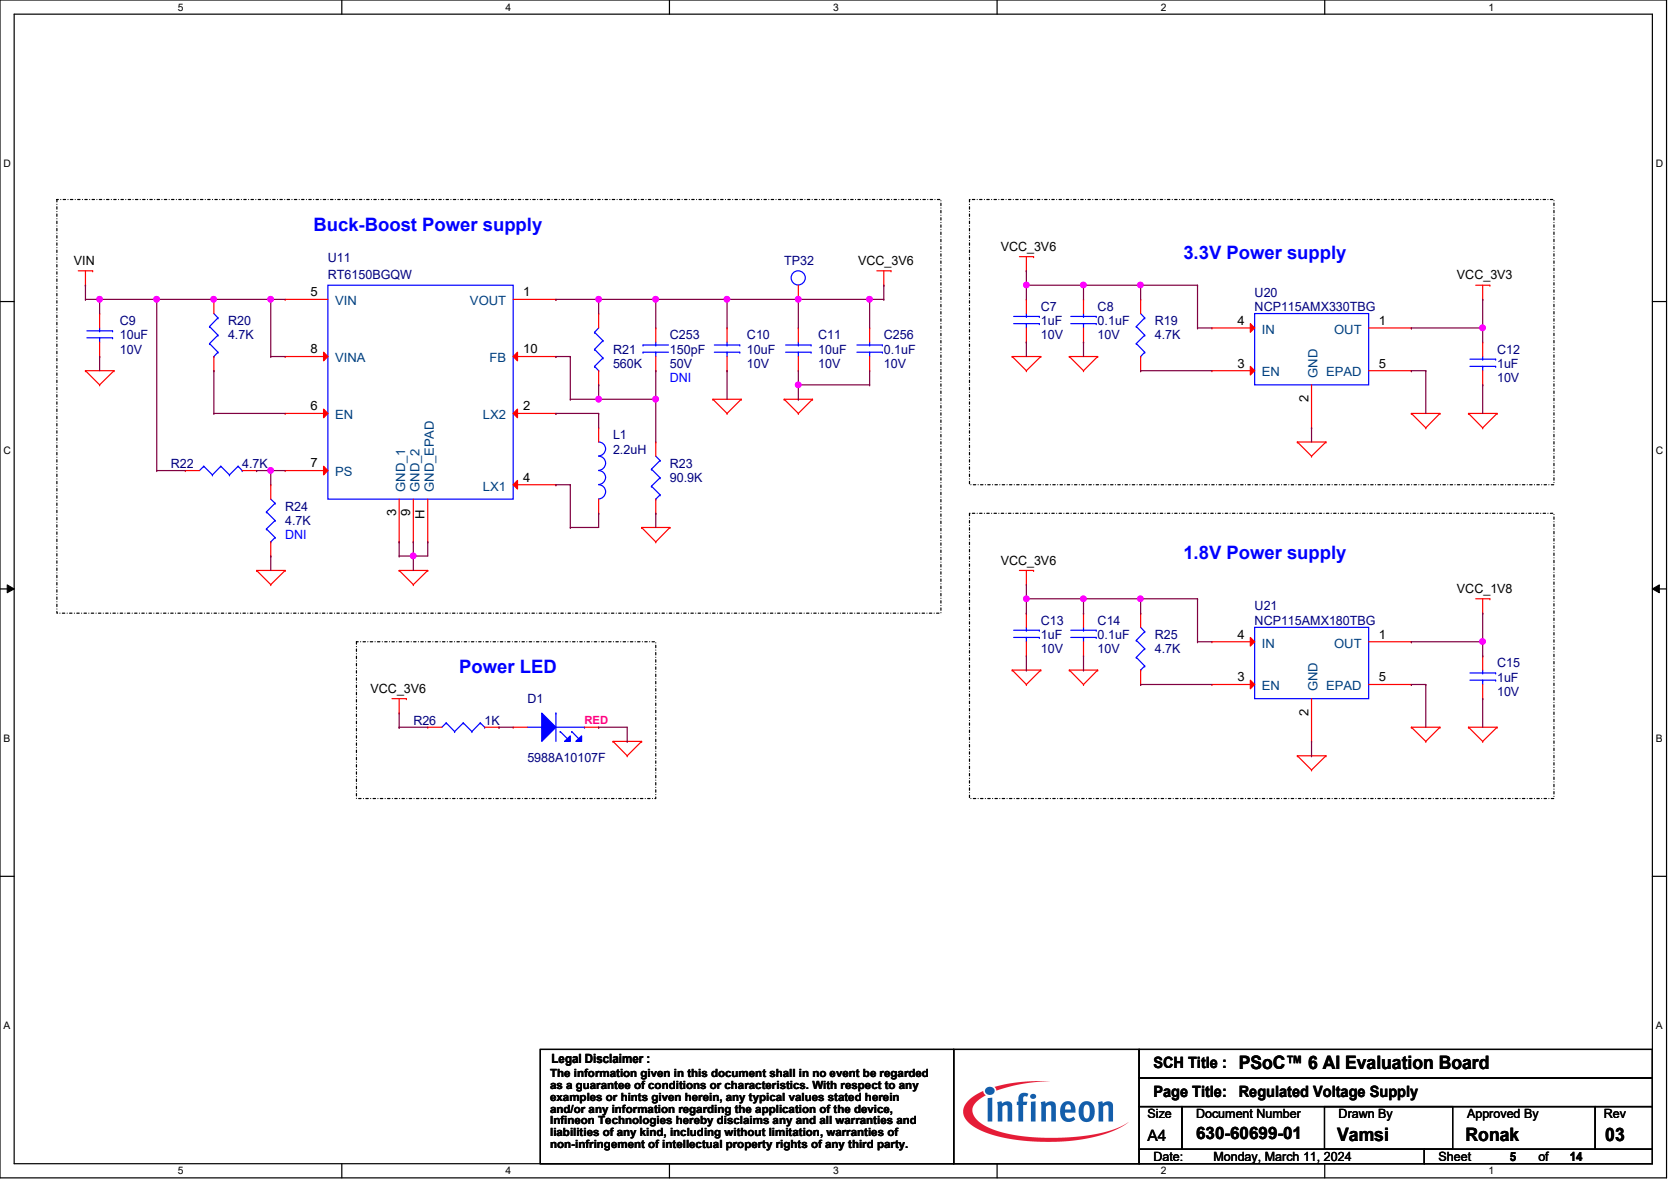
[picture p14: page 5]

Legal Disclaimer :
The information given in this document shall in no event be regarded
as a guarantee of conditions or characteristics. With respect to any

PSoC™ 6 AI Evaluation Board

PSoC™ 5LP Power | Decoupling Capacitors PSoC™ 5LP based KitProg3

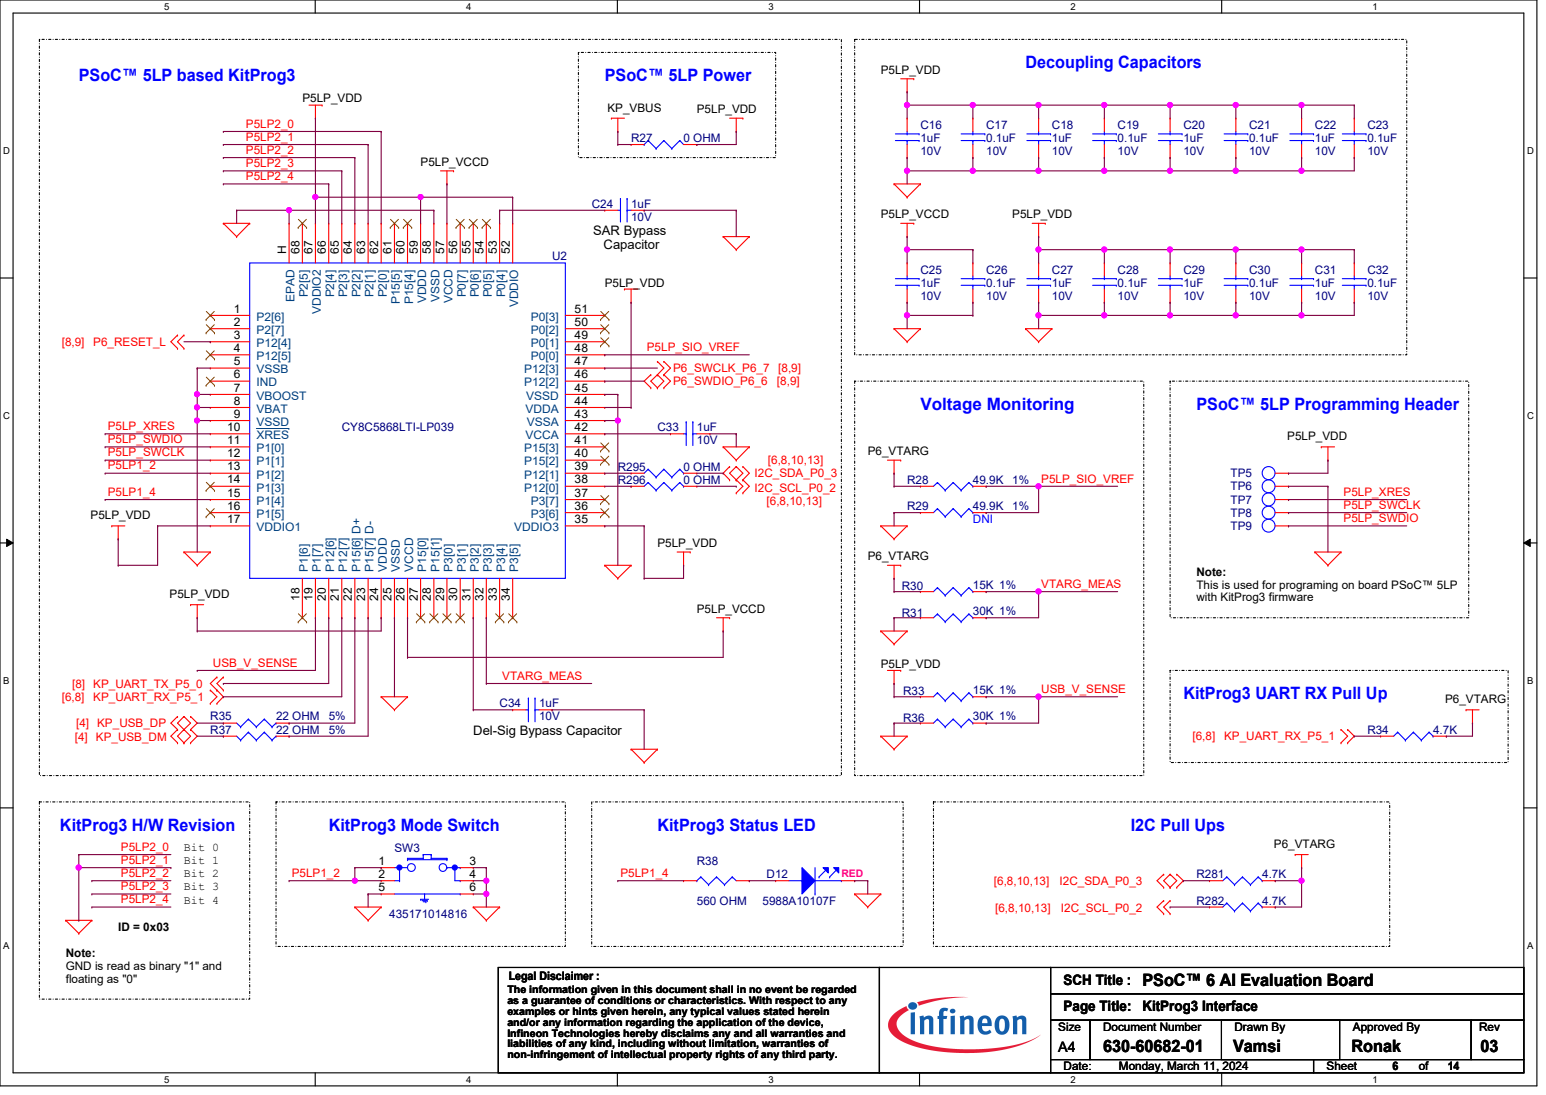
[picture p15: page 6]

Note:
This is used for programing on board PSoC™ 5LP
with KitProg3 firmware

KitProg3 UART RX Pull Up

Del-Sig Bypass Capacitor

GND is read as binary "1" and
floating as "0"

Legal Disclaimer :
The information given in this document shall in no event be regarded
as a guarantee of conditions or characteristics. With respect to any

PSoC™ 6 AI Evaluation Board

## PSoC™ 6 Power INPSoC™ 6 Power Supply

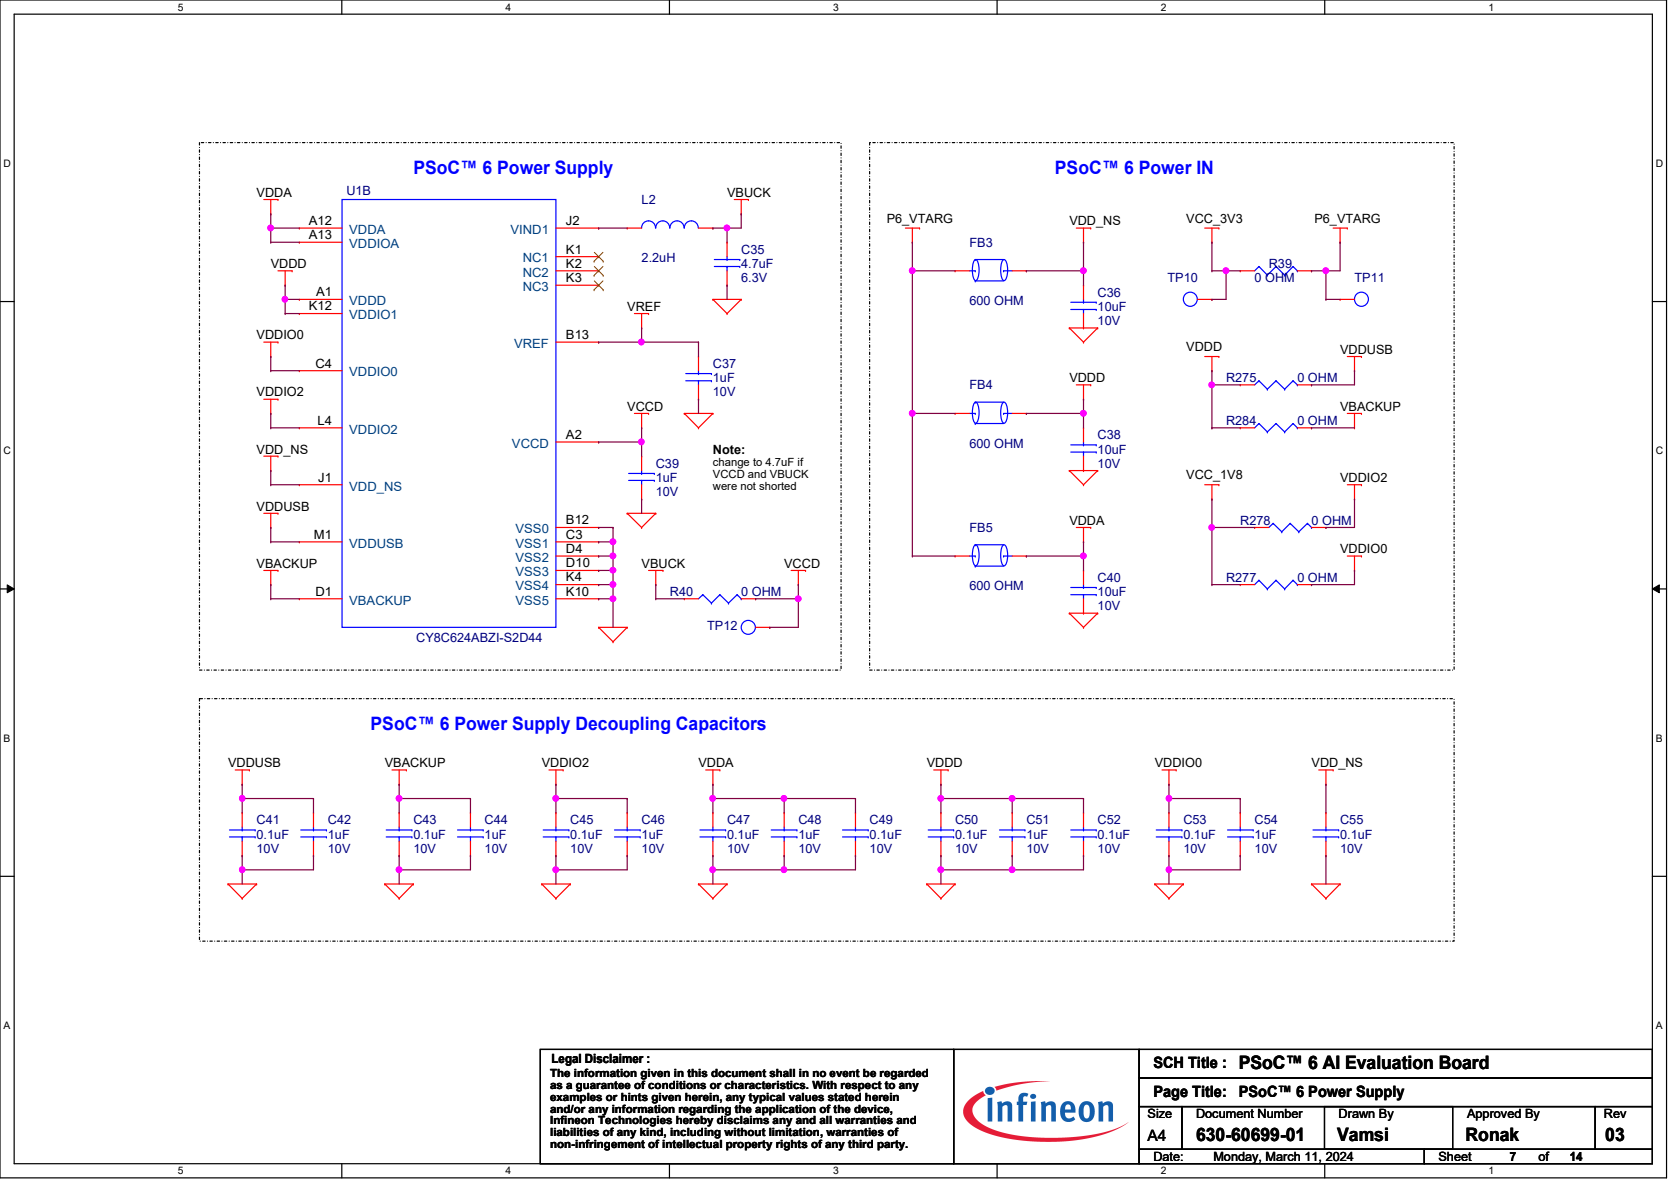
[picture p16: page 7]

PSoC™ 6 Power Supply Decoupling Capacitors

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

PSoC™ 6 AI Evaluation Board

## PSoC™ 6 I/O Signals

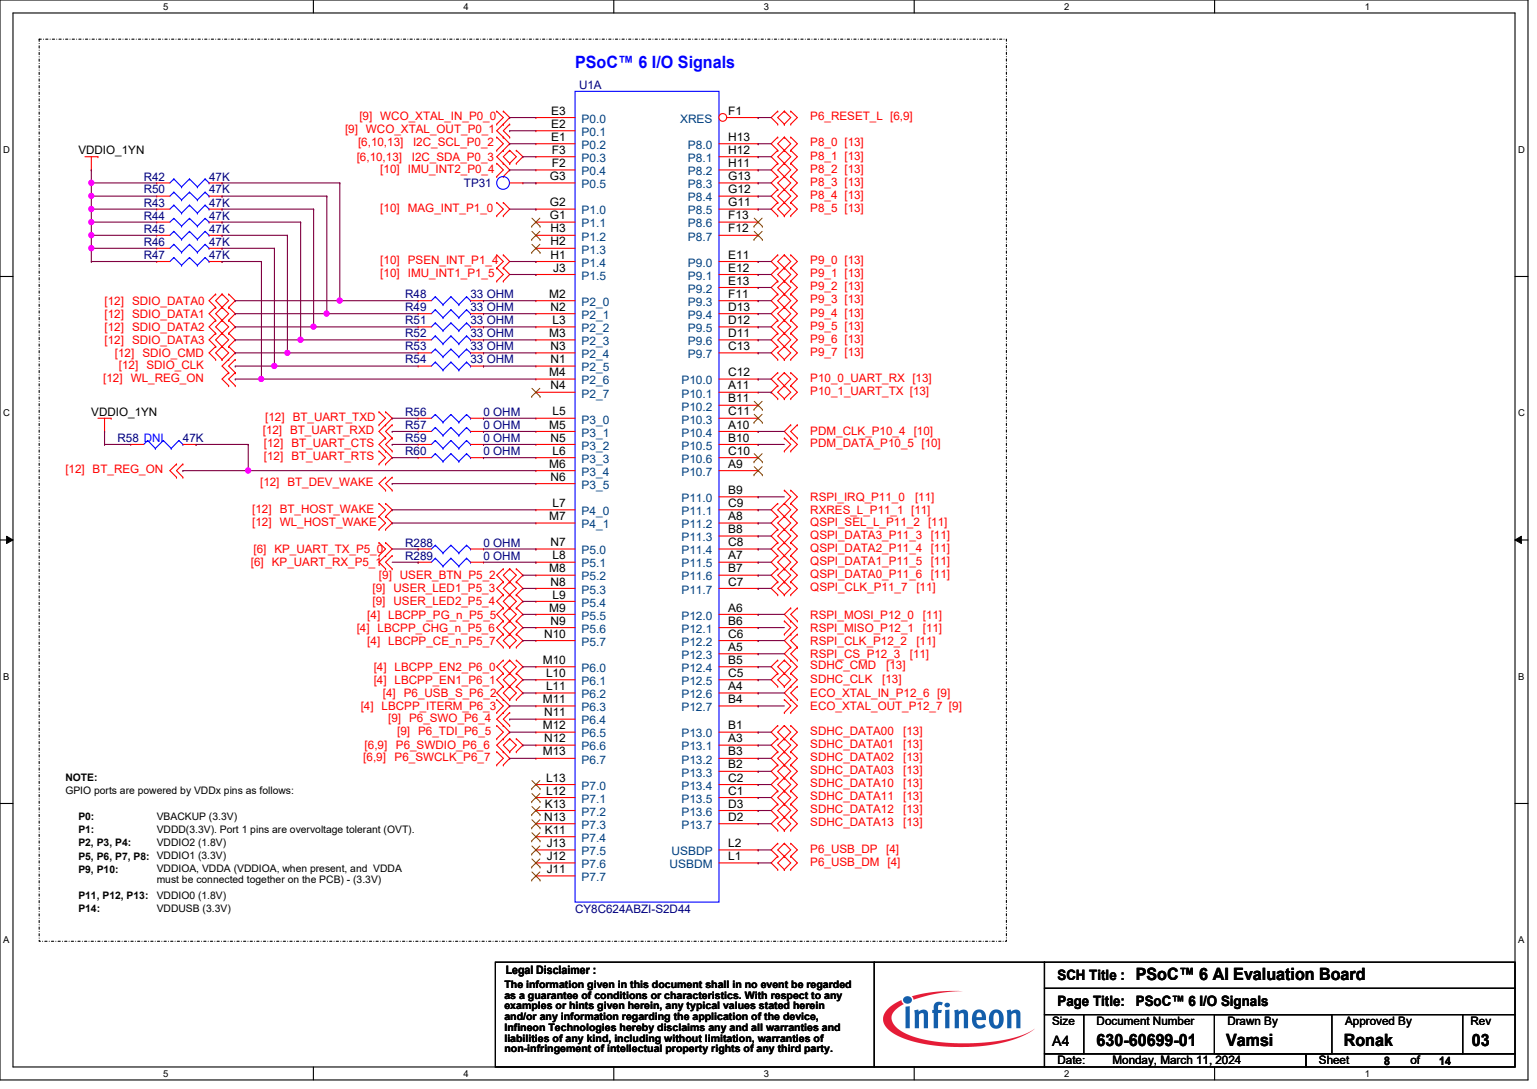
[picture p17: page 8]

NOTE:
GPIO ports are powered by VDDx pins as follows:

must be connected together on the PCB) - (3.3V)

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

PSoC™ 6 AI Evaluation Board

## PSoC™ 6 WCO SourcePSoC™ 6 ECO Source PSoC™ 6 SWD/JTAG Header

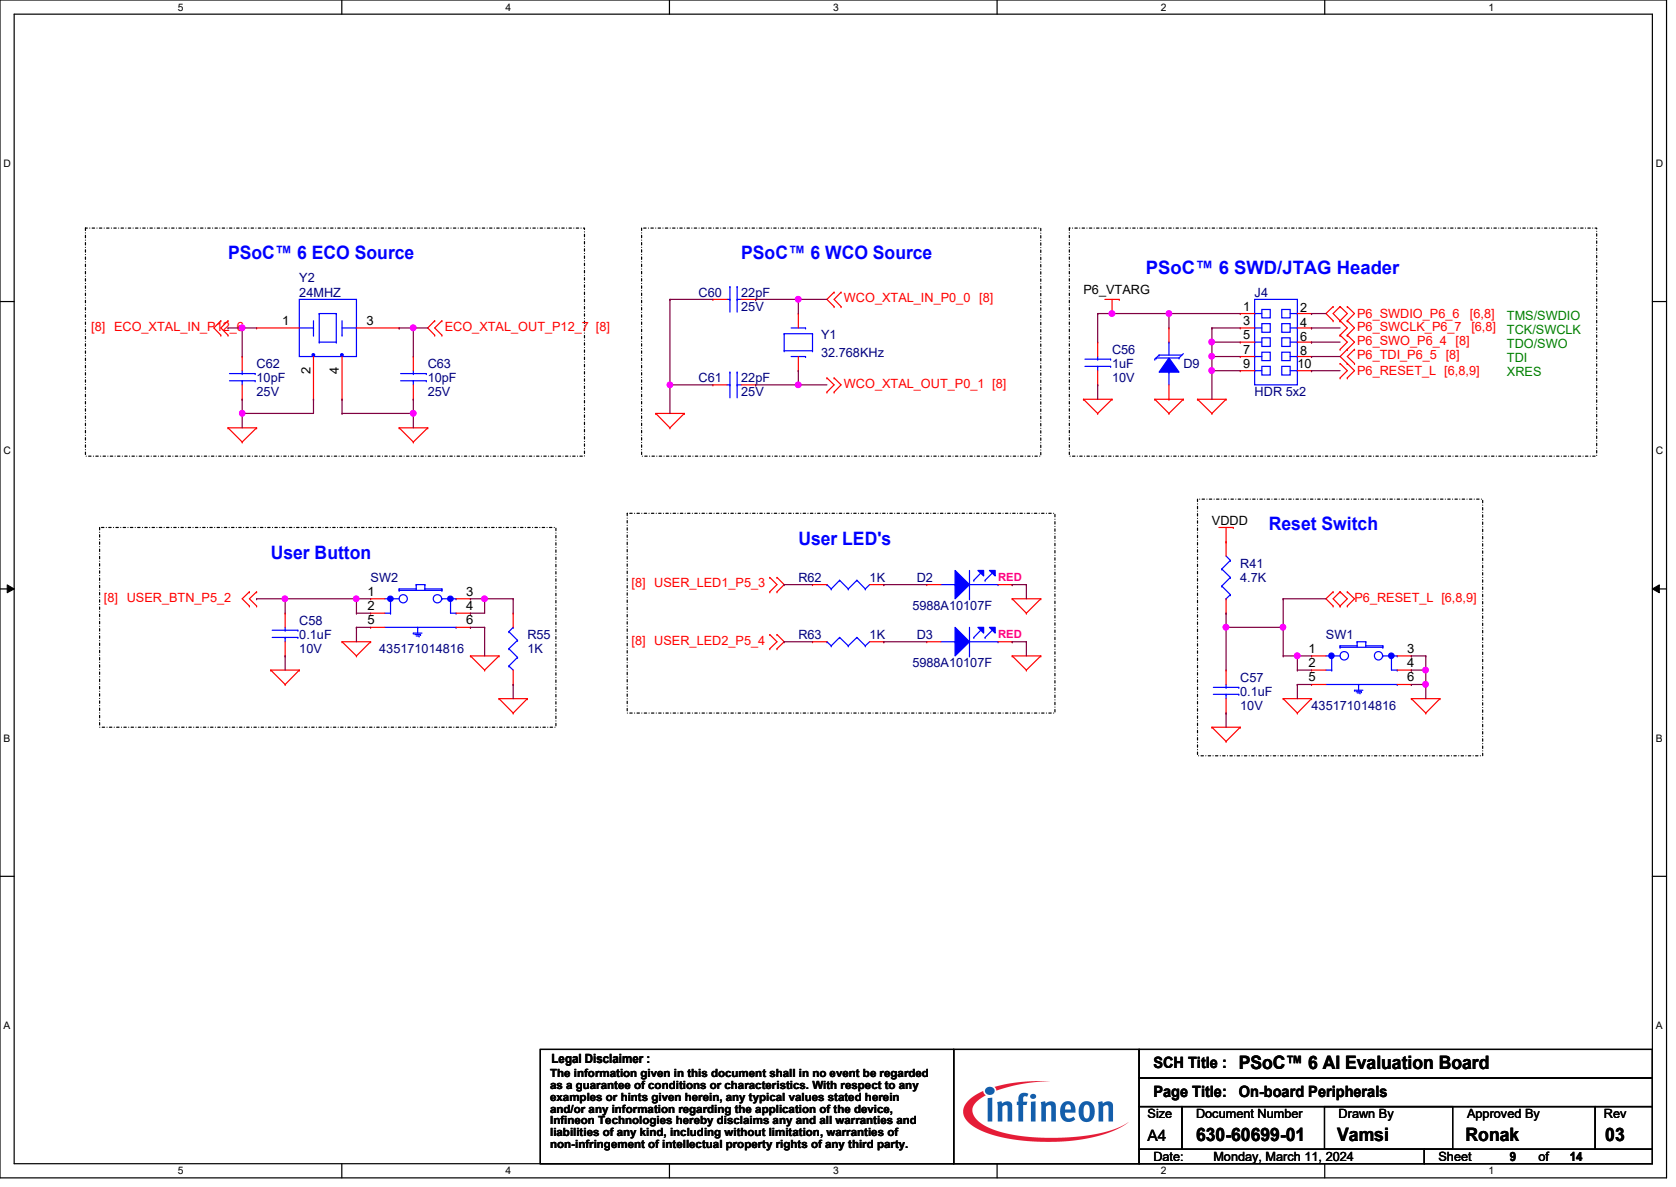
[picture p18: page 9]
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

PSoC™ 6 AI Evaluation Board

## Digital Barometric Pressure Sensor

## 6-axis IMU (Accelerometer + Gyroscope)

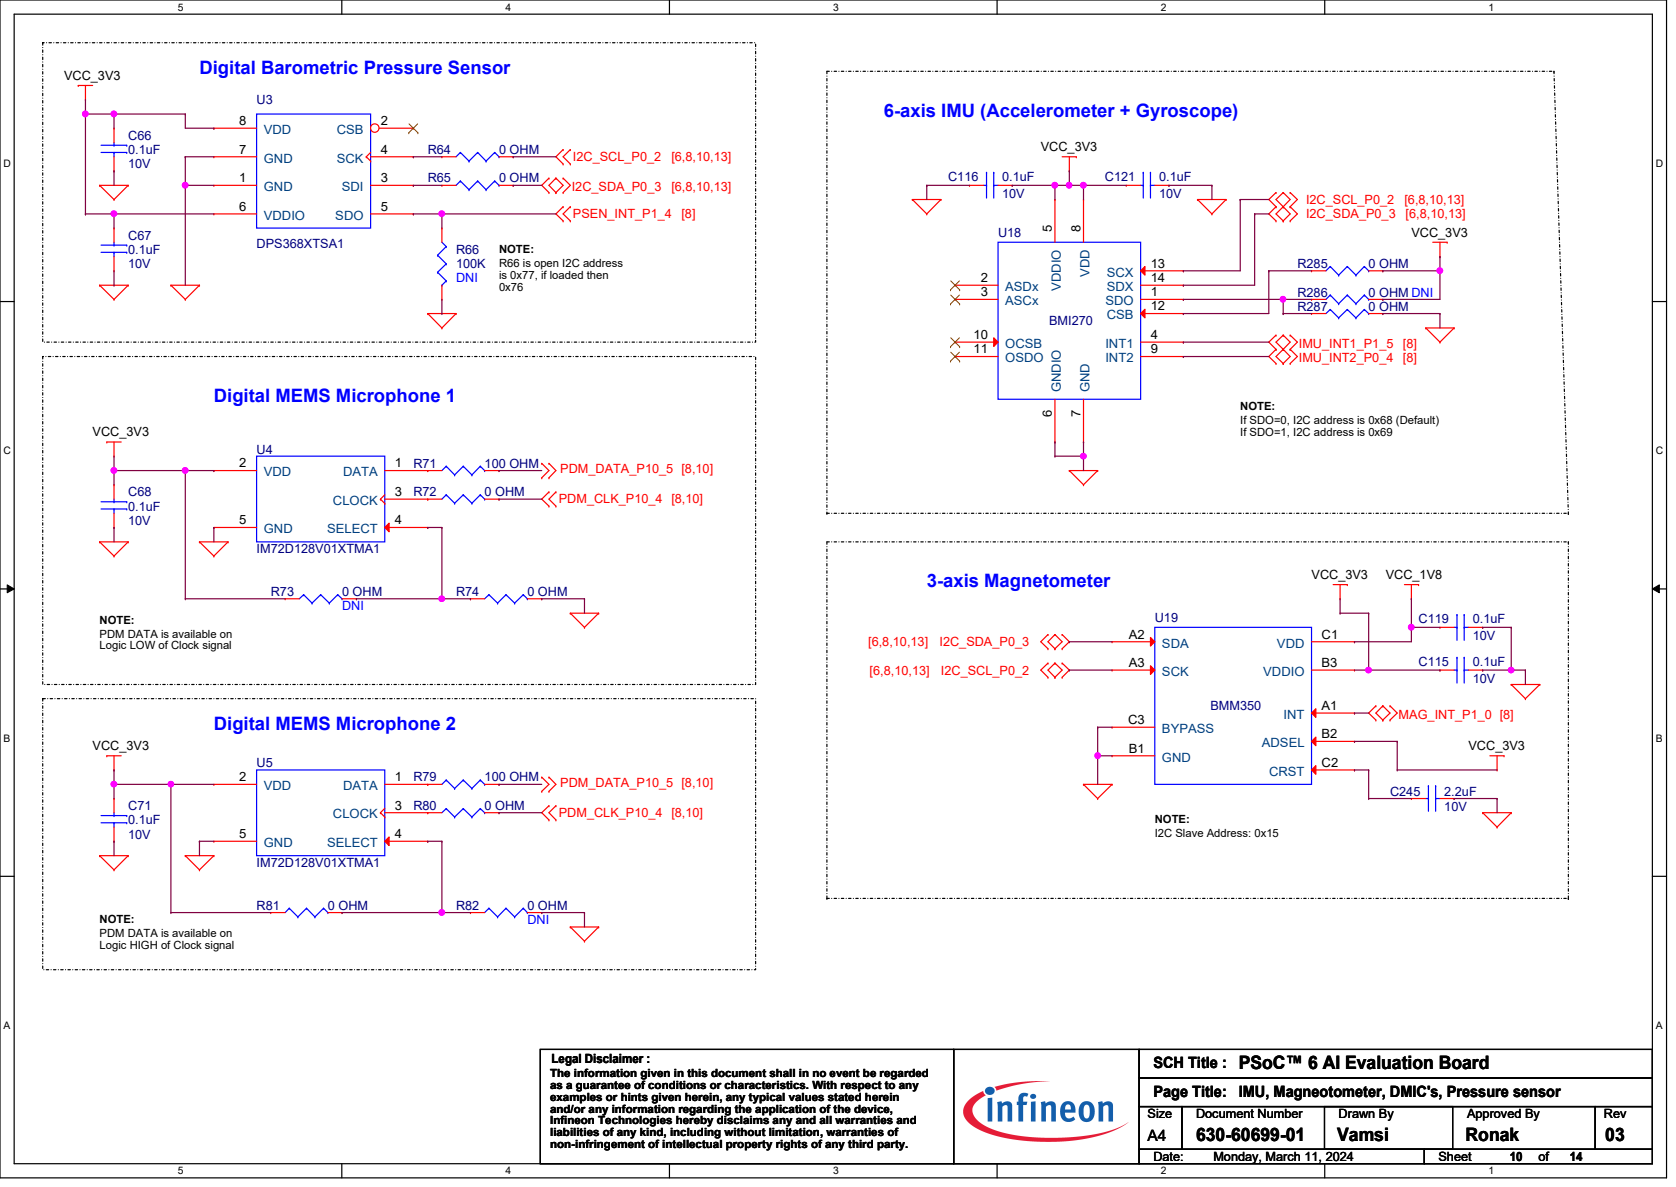
[picture p19: page 10]

NOTE:
R66 is open I2C address
is 0x77, if loaded then

If SDO=0, I2C address is 0x68 (Default)
If SDO=1, I2C address is 0x69

PDM DATA is available on
Logic LOW of Clock signal

Logic HIGH of Clock signal

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

PSoC™ 6 AI Evaluation Board

IMU, Magneotometer, DMIC's, Pressure sensor

## QSPI Memory interface

## RADAR Sensor

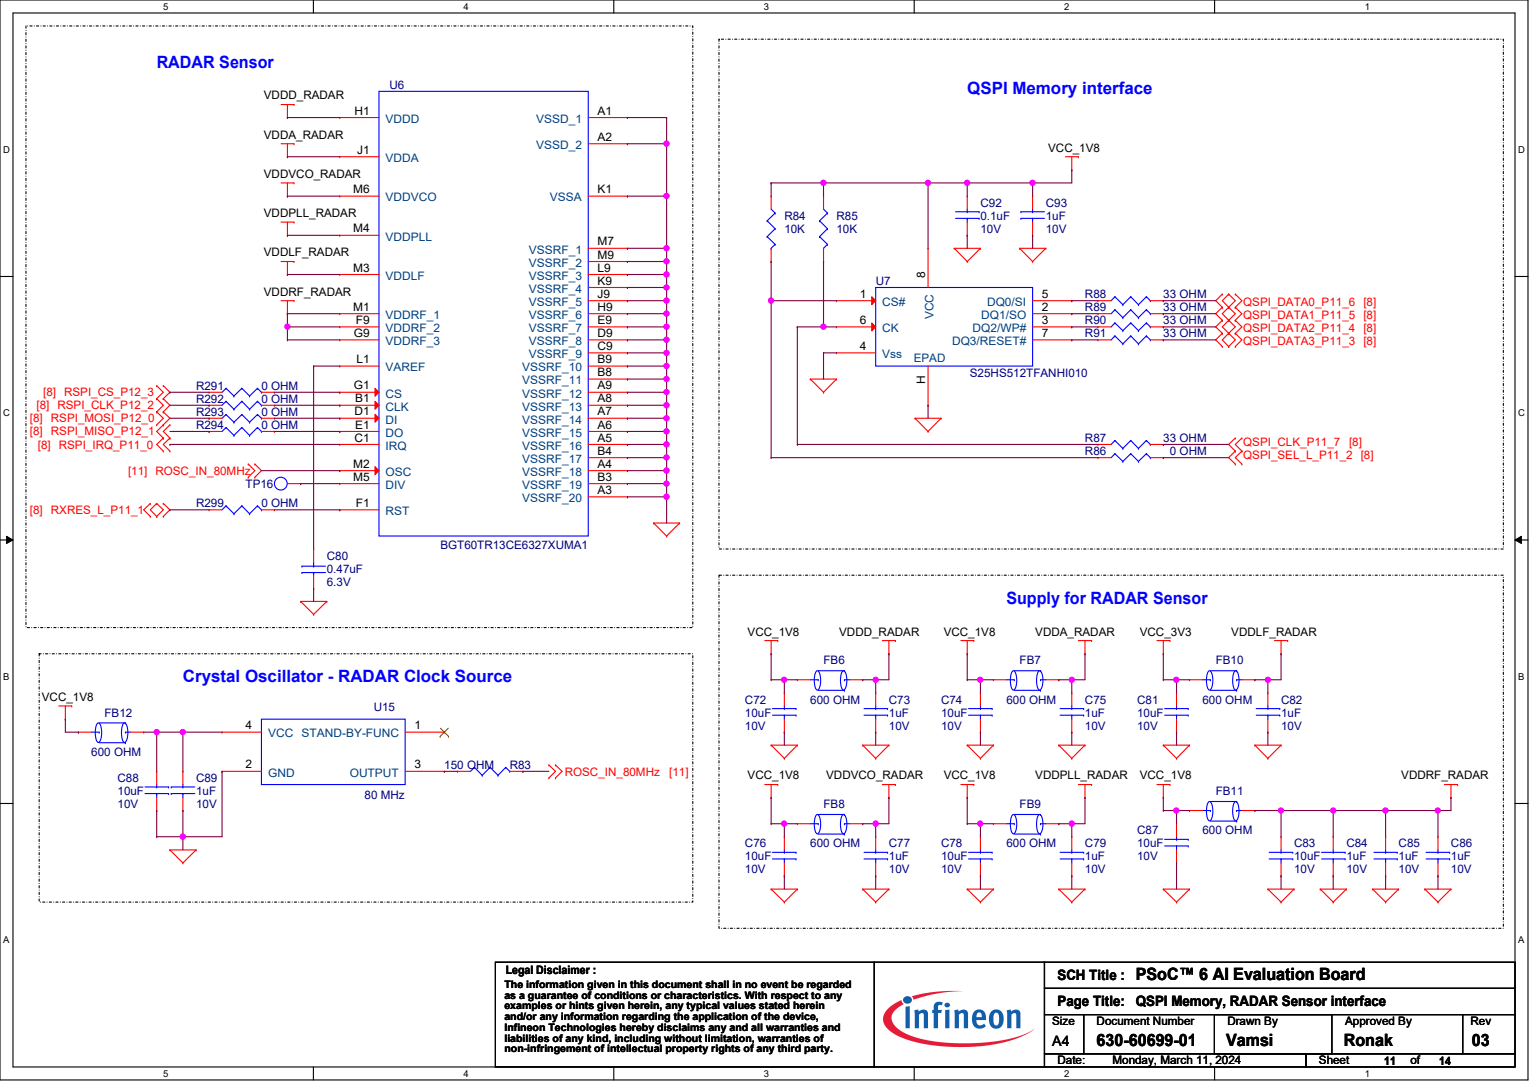
[picture p20: page 11]

Supply for RADAR Sensor

Crystal Oscillator - RADAR Clock Source

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

PSoC™ 6 AI Evaluation Board

QSPI Memory, RADAR Sensor interface

## 1YN Module Interface Signals

## Decoupling Capacitors for 1YN Module

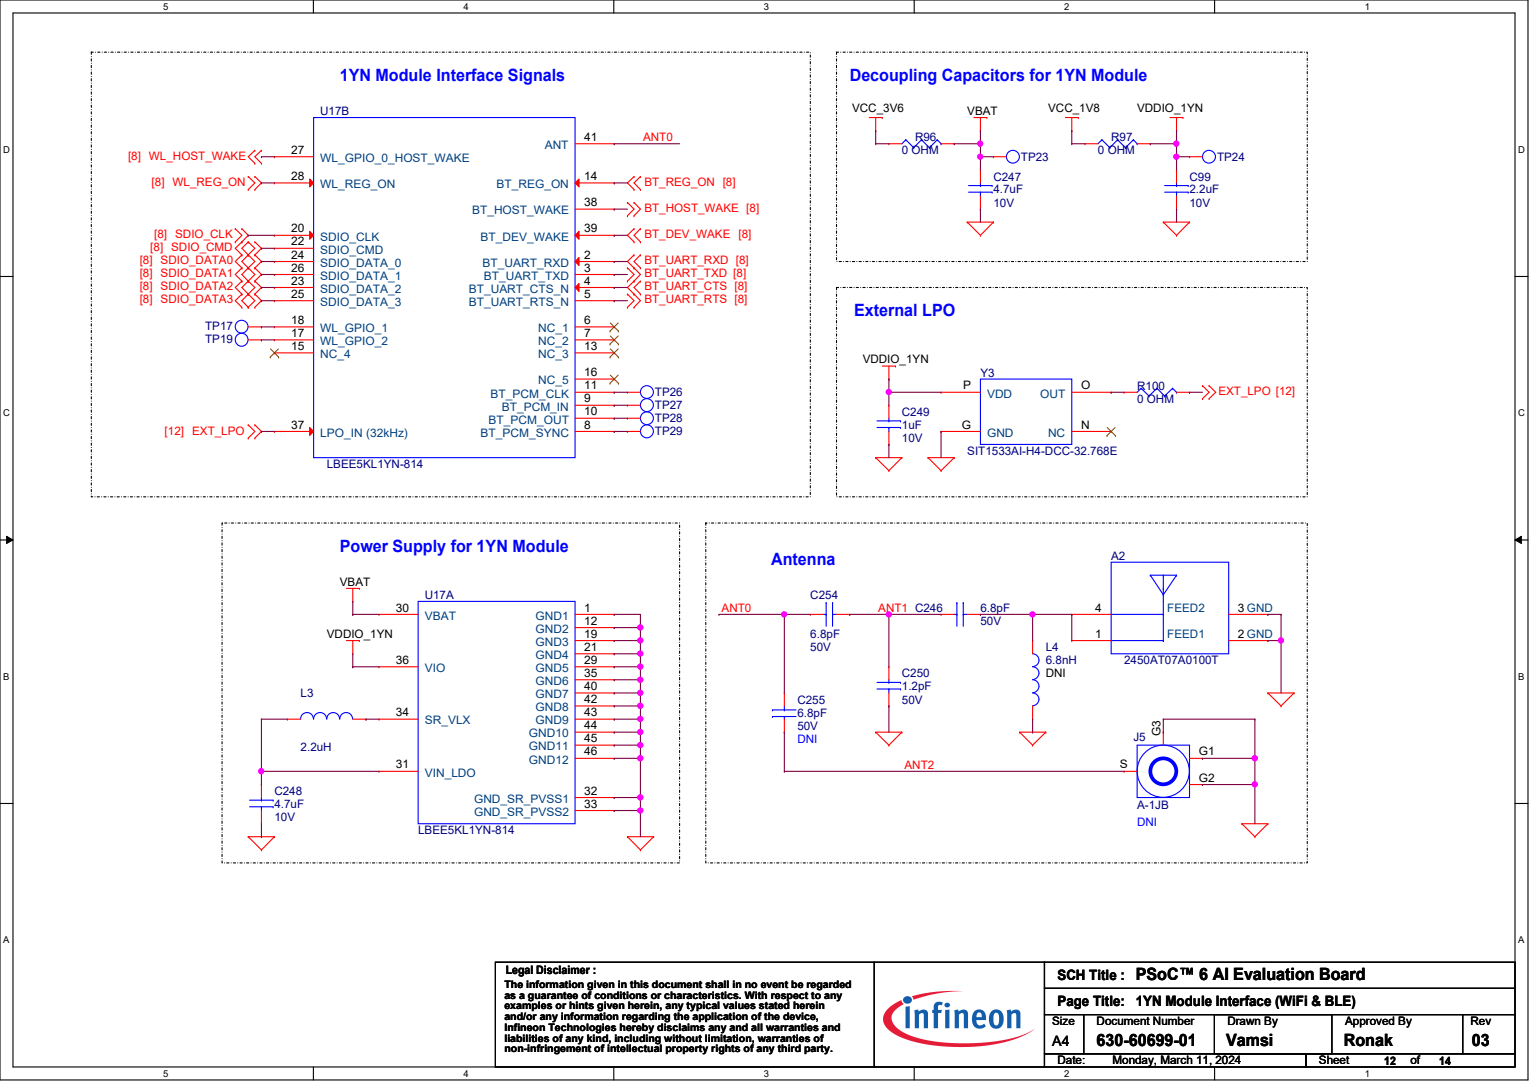
[picture p21: page 12]

Power Supply for 1YN Module

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

PSoC™ 6 AI Evaluation Board

1YN Module Interface (WiFi & BLE)

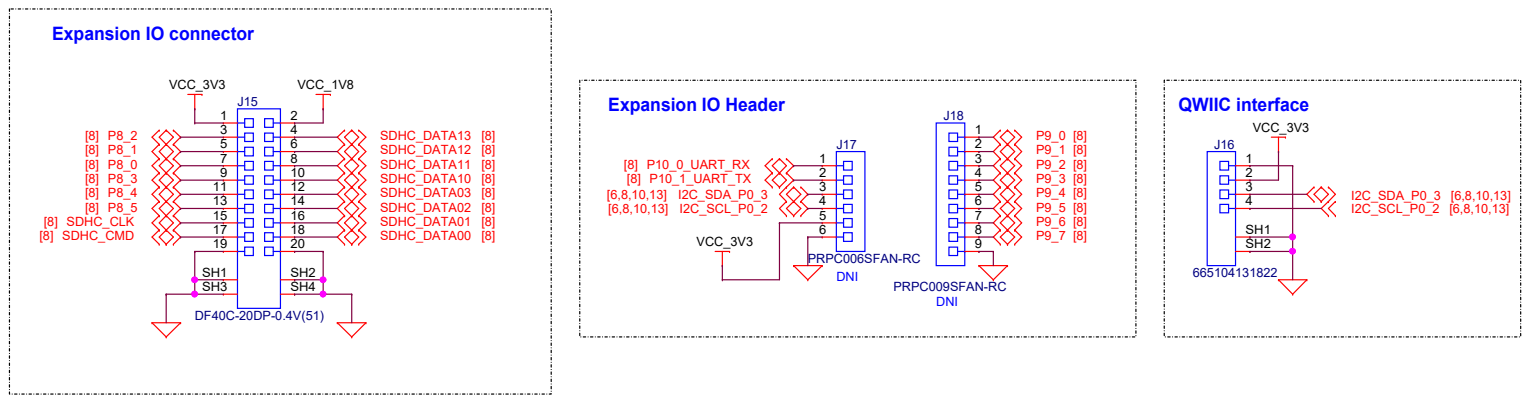
[picture p22: page 13]
QWIIC interface; VCC_3V3; VCC_1V8; I2C_SDA_P0_3[6,8,10,13] I2C_SCL_P0_2[6,8,10,13]; SDHC_DATA00 [8]; SDHC_DATA01 [8]; SDHC_DATA02 [8]; SDHC_DATA03 [8]; SDHC_DATA10 [8]; SDHC_DATA11 [8]; SDHC_DATA12 [8]; SDHC_DATA13 [8]; SDHC_CMD[8]; SDHC_CLK[8]; I2C_SCL_P0_2 [6,8,10,13] I2C_SDA_P0_3 [6,8,10,13]; P10_0_UART_RX[8] P10_1_UART_TX[8]; SCH Title :; Monday, March 11, 2024; PRPC009SFAN-RC; DNI; PRPC006SFAN-RC

Expansion IO connector

Expansion IO Header

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

PSoC™ 6 AI Evaluation Board

IO Expansion, QWIIC and Headers

D D

C C

B B

A A

# DESCRIPTION OF CHANGEREV

0.01

# DATE

# REVISION HISTORY

| Initial darft schematic | 08-11-2023
Fixing the Open Net issues0.02 | 13-11-2023
Updated QSPI memory and added IO expansion header with I2C, UART and SmartIO interface0.03 | 16-11-2023
06-12-202301 | Initial release

## 02 06-02-2024UART signals are updated for J17

03 | Microphone changed to IM72D series | 11-03-2024

## SCH Title :

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

Legal Disclaimer :

## PSoC™ 6 AI Evaluation Board

Friday, April 19, 2024 | 14 | 14

## Revision History

## SCH Title :

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

Legal Disclaimer :

## PSoC™ 6 AI Evaluation Board

Friday, April 19, 2024 | 14 | 14

## Revision History

## SCH Title :

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

Legal Disclaimer :

## PSoC™ 6 AI Evaluation Board

Friday, April 19, 2024 | 14 | 14

## Revision History
