XiaoKChen/Work-Normal-Corperation-Altium/Board/infineon-cy8ckit-062s2-ai-psoc-6-ai-evaluation-board-hardware-pcbdesigndata-en/CY8CKIT-062S2-AI PSoC 6 AI Evaluation Board Layout.pdf

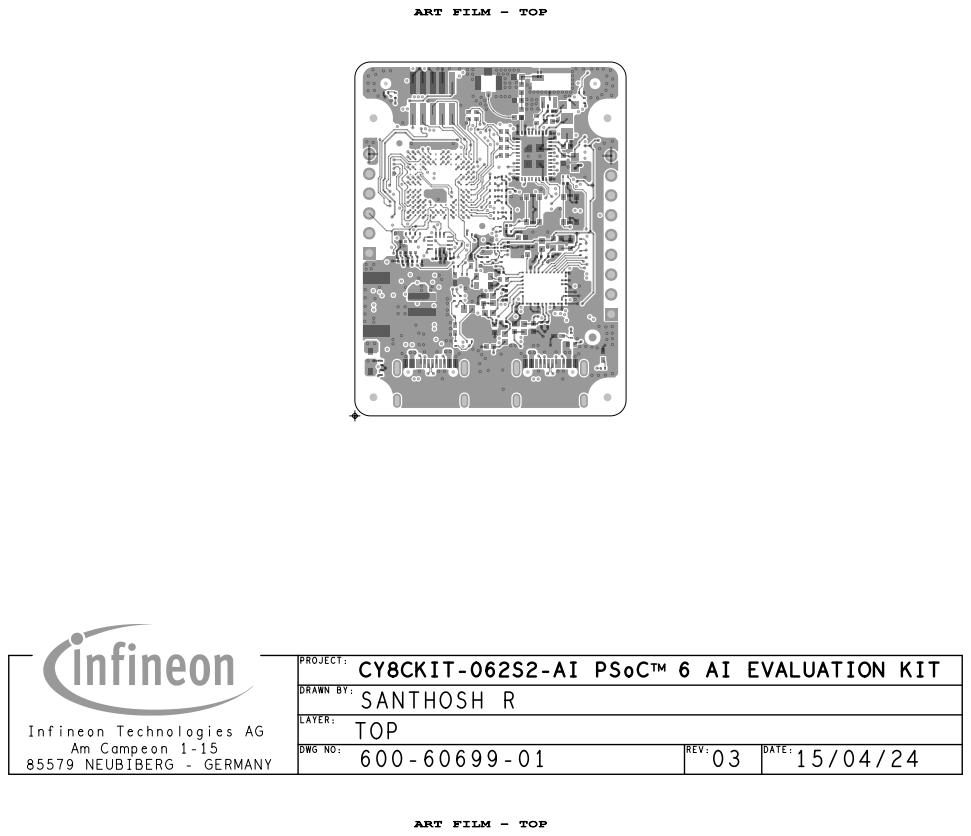
[picture p23: page 1]
85579 NEUBIBERG - GERMANY; Am Campeon 1-15; DWG NO:; LAYER:; PROJECT:; CY8CKIT-062S2-AI PSoC; 6 AI EVALUATION; KIT TM

ART FILM - TOP

DRAWN BY: SANTHOSH R

Infineon Technologies AG

TOP
600-60699-01 | REV: 03 | DATE: 15/04/24

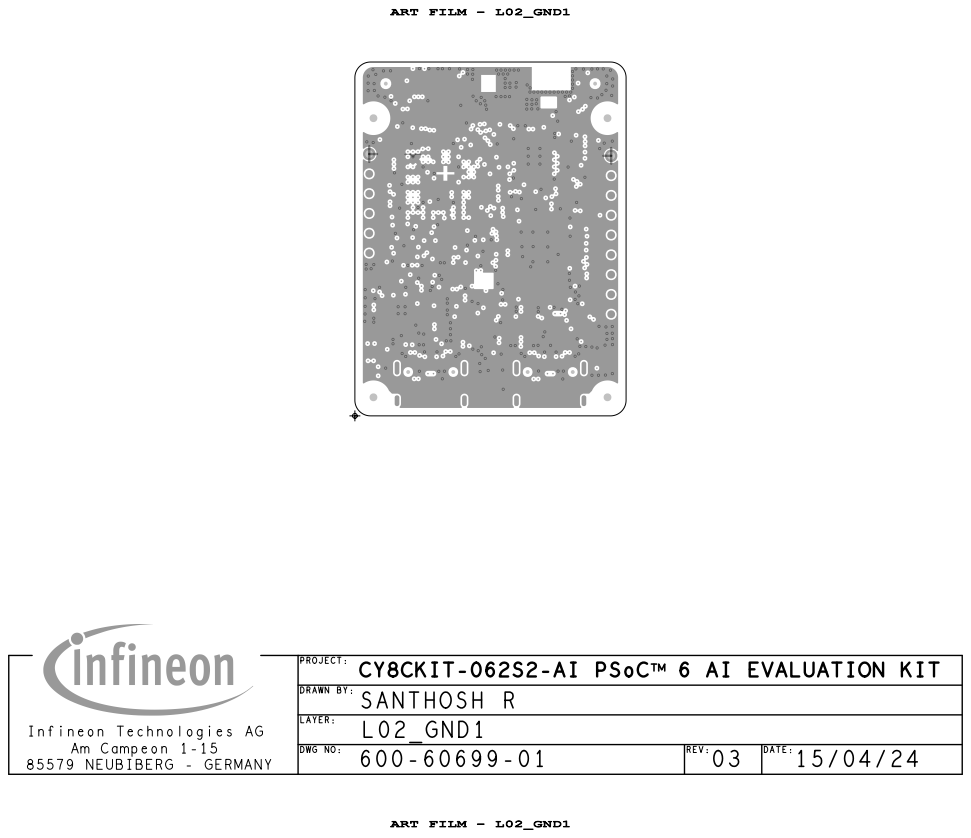
[picture p24: page 2]
ART FILM - L02_GND1; 85579 NEUBIBERG - GERMANY; Am Campeon 1-15; DWG NO:; LAYER:; DRAWN BY:; PROJECT:; L02_GND1; SANTHOSH R; CY8CKIT-062S2-AI PSoC; 6 AI EVALUATION; KIT TM; REV:; DATE:

Infineon Technologies AG

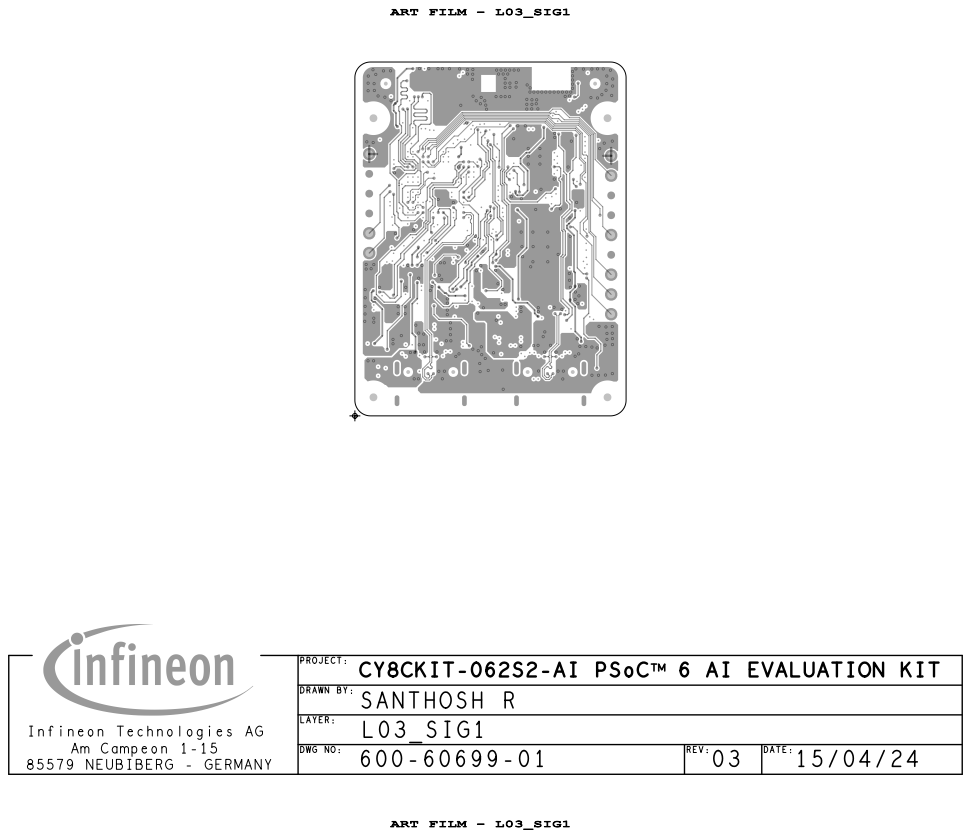
[picture p25: page 3]
ART FILM - L03_SIG1; 85579 NEUBIBERG - GERMANY; Am Campeon 1-15; DWG NO:; PROJECT:; CY8CKIT-062S2-AI PSoC; 6 AI EVALUATION; KIT TM

DRAWN BY: SANTHOSH R

LAYER: L03_SIG1

Infineon Technologies AG

600-60699-01 | REV: 03 | DATE: 15/04/24

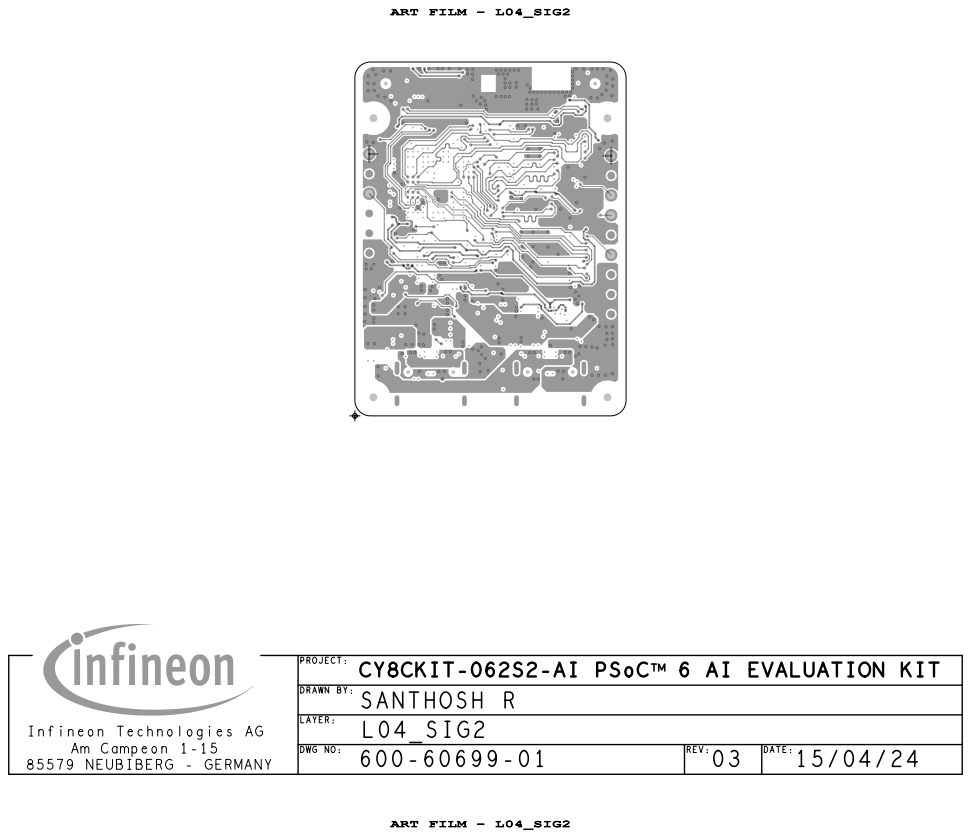
[picture p26: page 4]
ART FILM - L04_SIG2; 85579 NEUBIBERG - GERMANY; Am Campeon 1-15; DWG NO:; PROJECT:; CY8CKIT-062S2-AI PSoC; 6 AI EVALUATION; KIT TM

DRAWN BY: SANTHOSH R

LAYER: L04_SIG2

Infineon Technologies AG

600-60699-01 | REV: 03 | DATE: 15/04/24

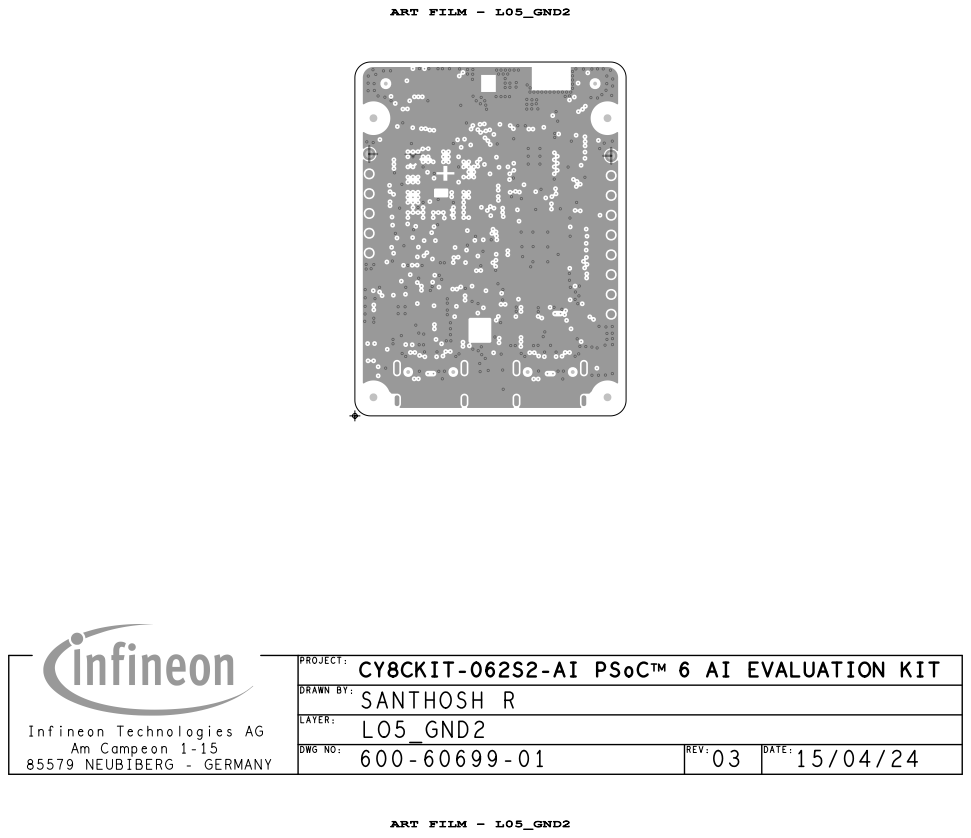
[picture p27: page 5]
ART FILM - L05_GND2; 85579 NEUBIBERG - GERMANY; Am Campeon 1-15; DWG NO:; LAYER:; DRAWN BY:; PROJECT:; LO5_GND2; SANTHOSH R; CY8CKIT-062S2-AI PSoC; 6 AI EVALUATION; KIT TM; REV:; DATE:

Infineon Technologies AG

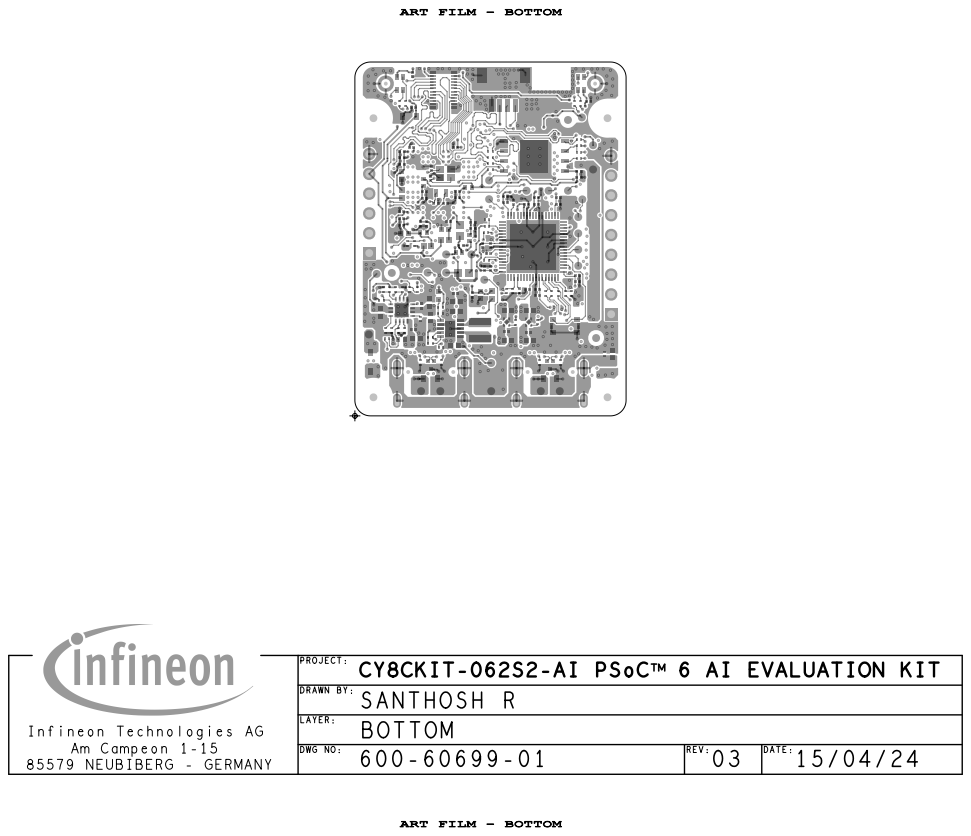
[picture p28: page 6]
85579 NEUBIBERG - GERMANY; Am Campeon 1-15; DWG NO:; PROJECT:; CY8CKIT-062S2-AI PSoC; 6 AI EVALUATION; KIT TM

ART FILM - BOTTOM

DRAWN BY: SANTHOSH R

LAYER: BOTTOM

Infineon Technologies AG

600-60699-01 | REV: 03 | DATE: 15/04/24

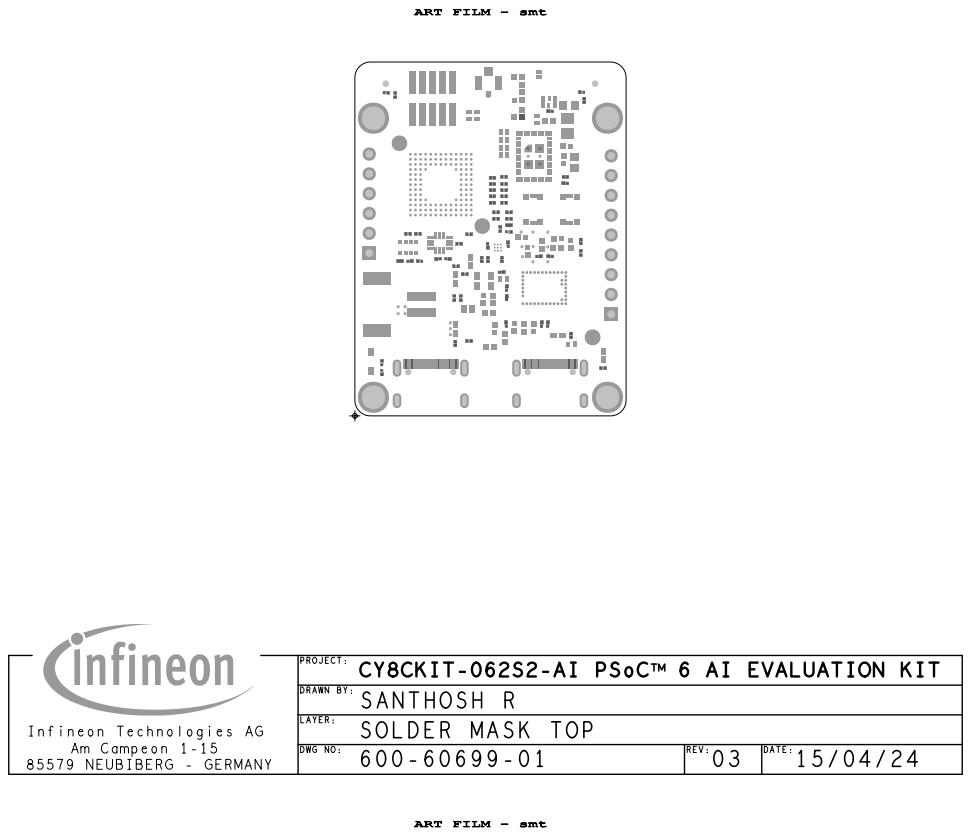
[picture p29: page 7]
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

ART FILM - smt

DRAWN BY: SANTHOSH R

LAYER: SOLDER MASK TOP

Infineon Technologies AG

600-60699-01 | REV: 03 | DATE: 15/04/24

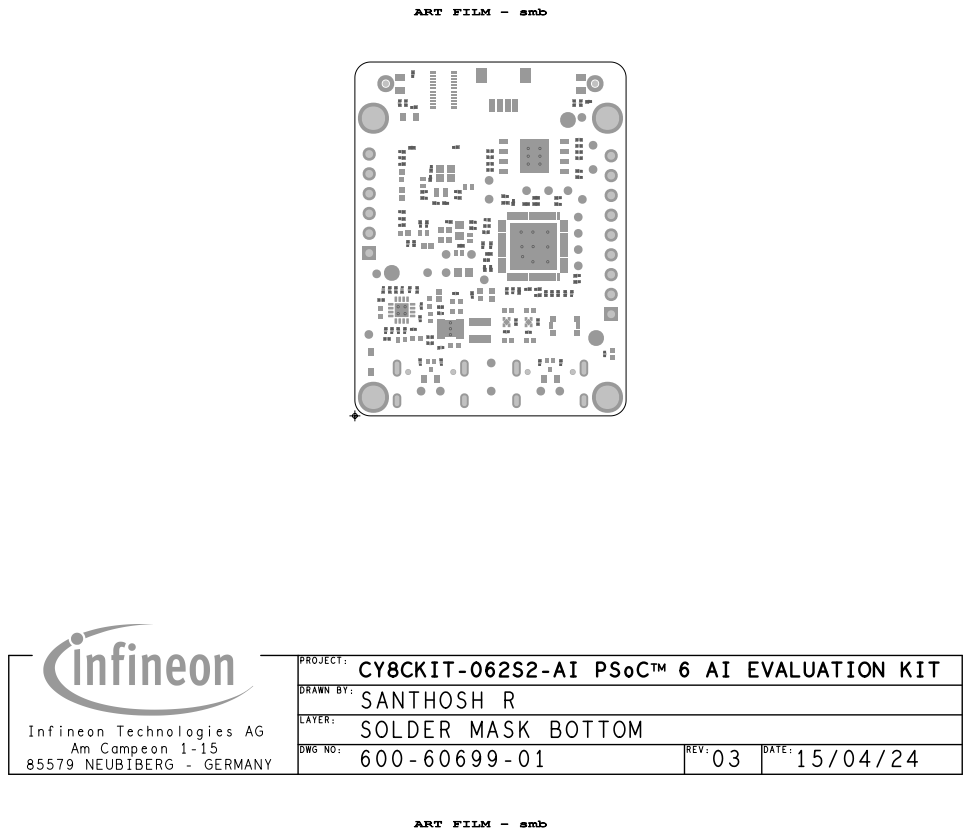
[picture p30: page 8]
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

ART FILM - smb

DRAWN BY: SANTHOSH R

LAYER: SOLDER MASK BOTTOM

Infineon Technologies AG

600-60699-01 | REV: 03 | DATE: 15/04/24

U19U17

C255C246

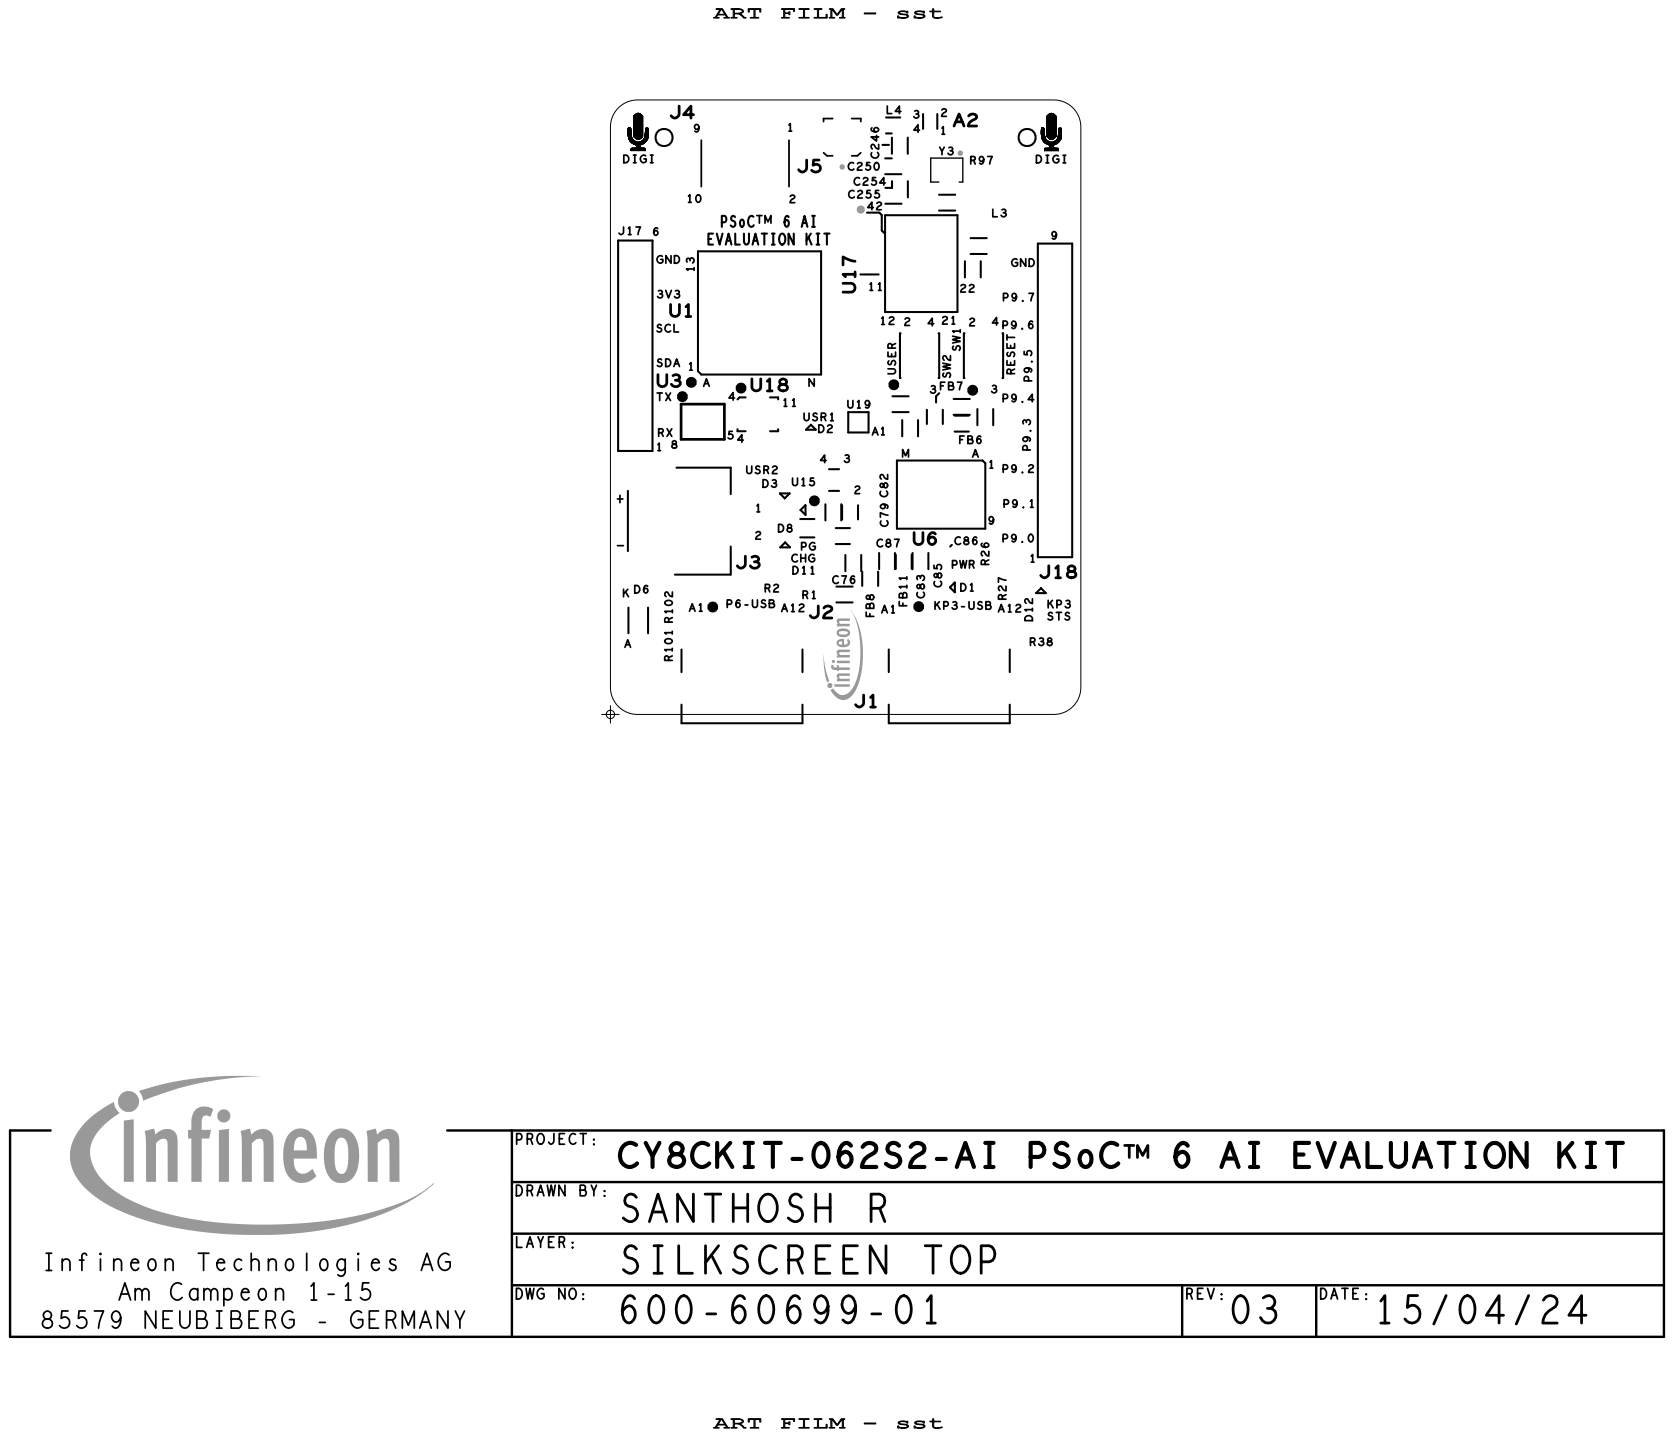
[picture p31: page 9]

DRAWN BY: SANTHOSH R

LAYER: SILKSCREEN TOP

600-60699-01 | REV: 03 | DATE: 15/04/24

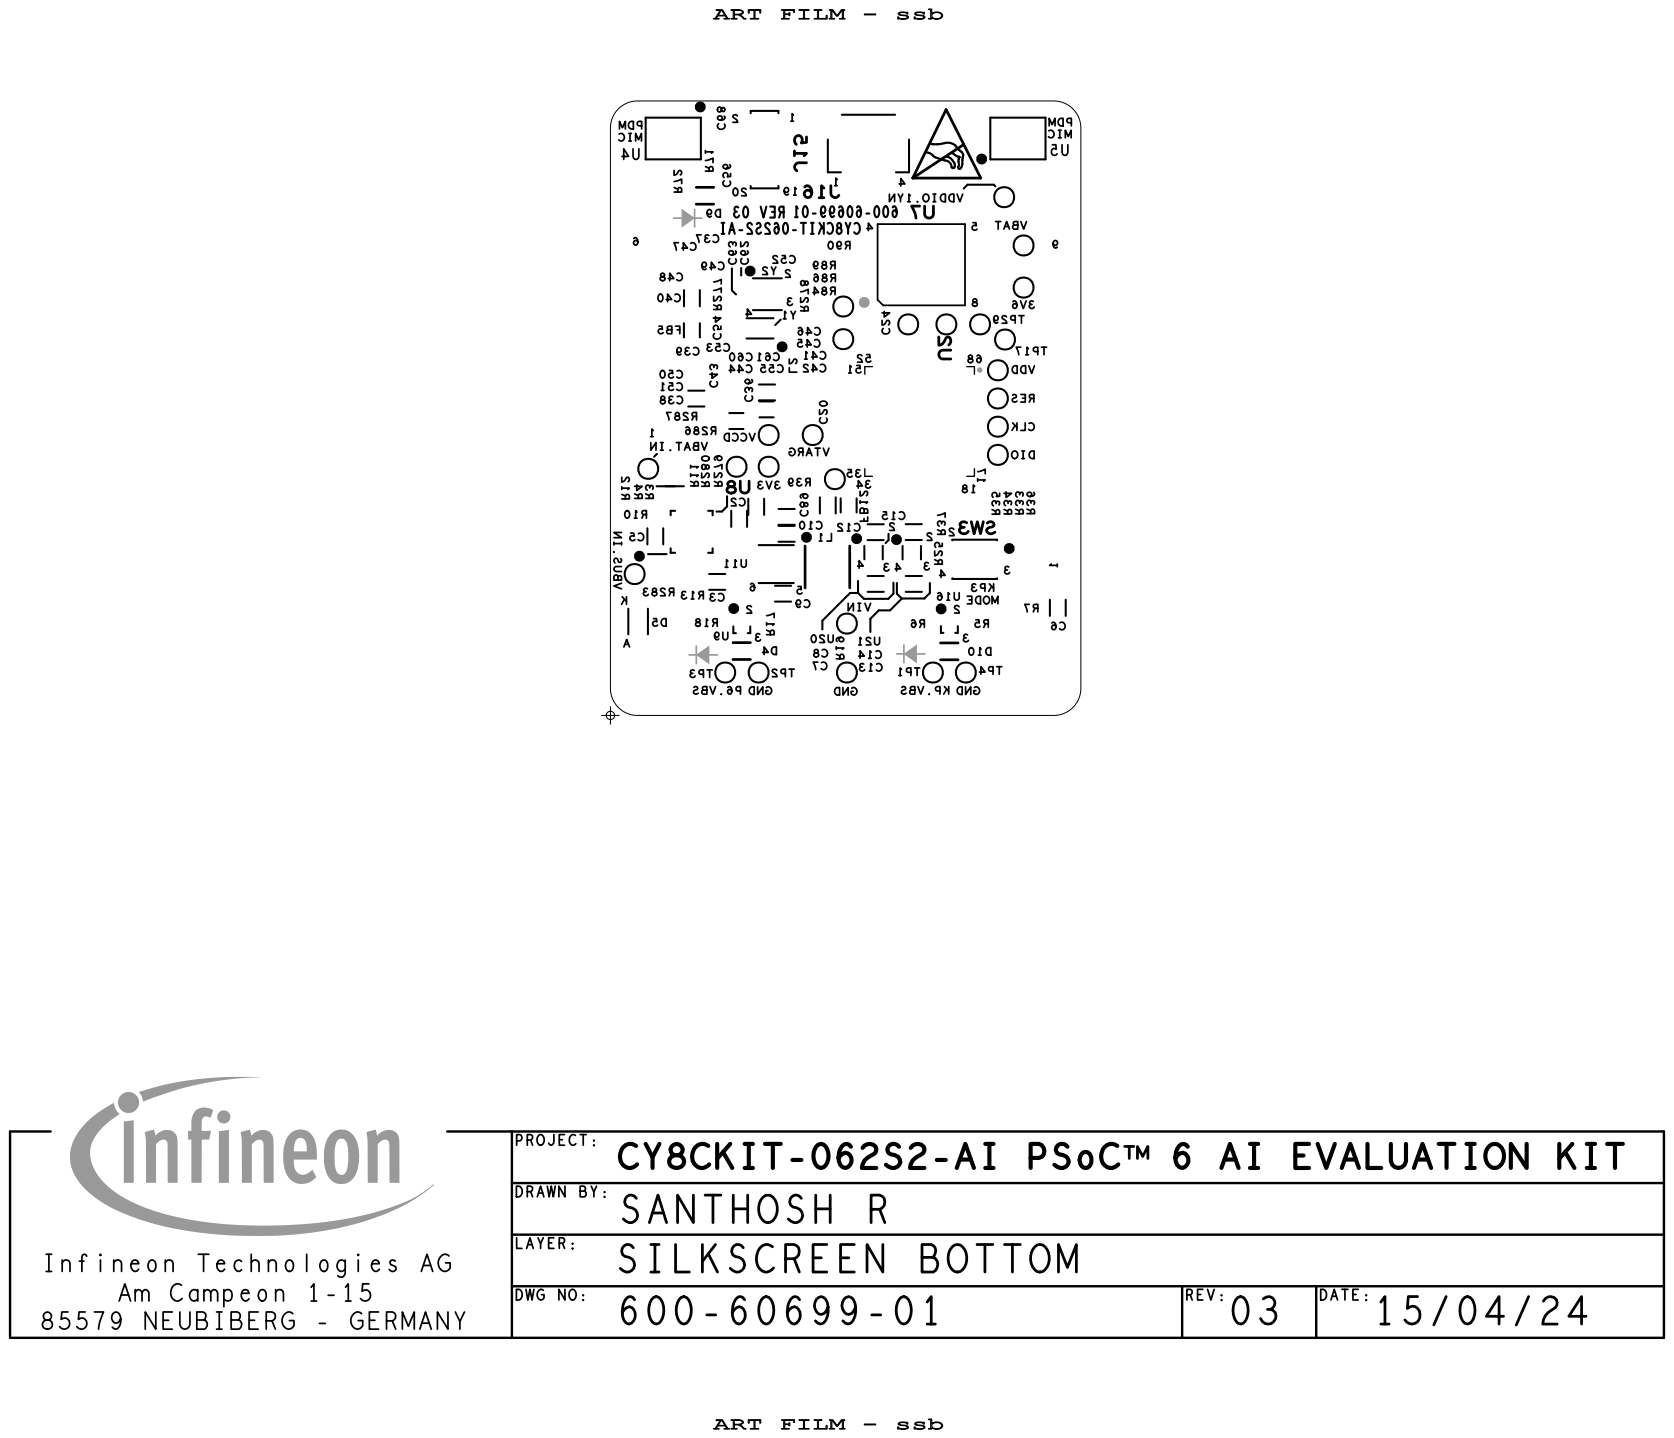
[picture p32: page 10]

DRAWN BY: SANTHOSH R

LAYER: SILKSCREEN BOTTOM

600-60699-01 | REV: 03 | DATE: 15/04/24

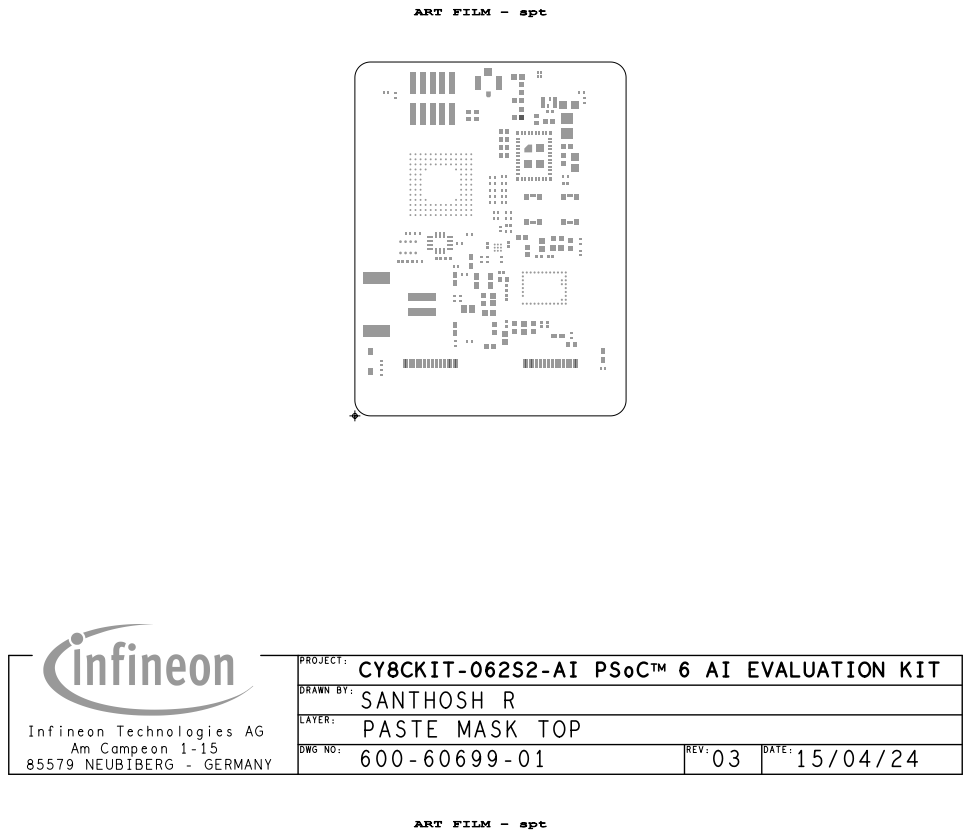
[picture p33: page 11]
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

ART FILM - spt

DRAWN BY: SANTHOSH R

LAYER: PASTE MASK TOP

Infineon Technologies AG

600-60699-01 | REV: 03 | DATE: 15/04/24

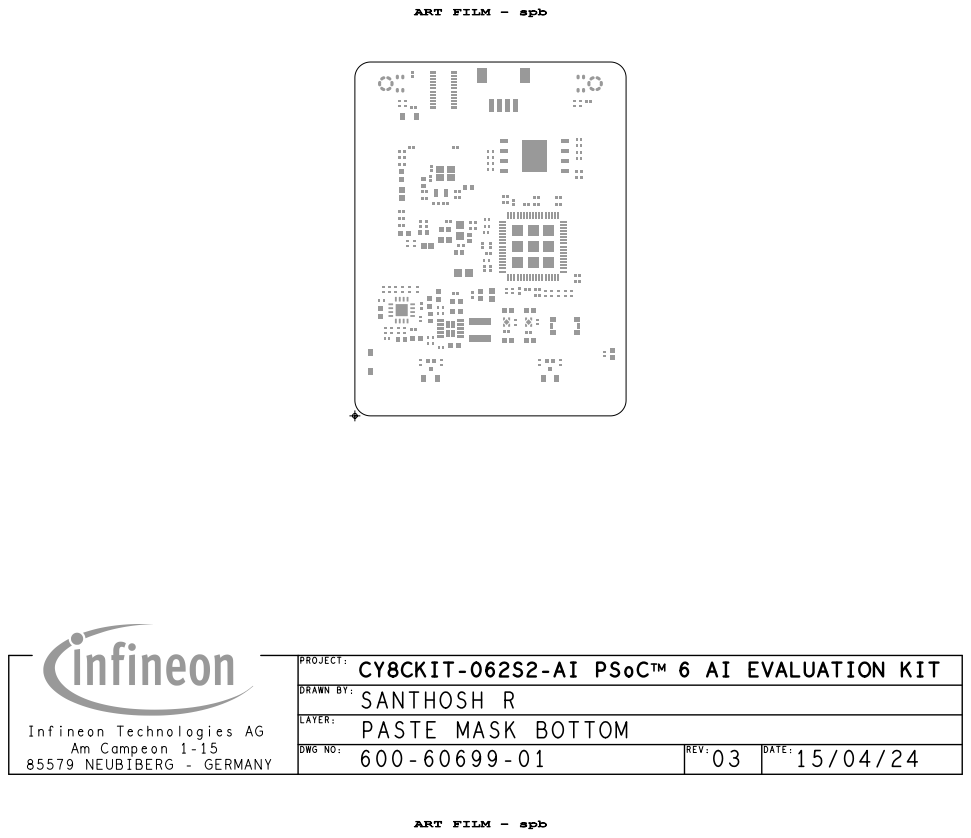
[picture p34: page 12]
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

ART FILM - spb

DRAWN BY: SANTHOSH R

LAYER: PASTE MASK BOTTOM

Infineon Technologies AG

600-60699-01 | REV: 03 | DATE: 15/04/24
