XiaoKChen/Work-Normal-Corperation-Altium/(list of files, drawings)

Other design files:
Board/infineon-pcb-footprints-and-symbols-bgt60tr13c-60ghz-radar-altium-pcbdesigndata-en/BGT60TR13C.SchLib
Components/LIB_20021121-00010C4LF/20021121-00010C4LF/Altium/20021121-00010C4LF.SchLib
Components/LIB_20021121-00010C4LF/20021121-00010C4LF/Altium/2002112100010C4LF.PcbLib
Components/LIB_APHHS1005LQBC_D-V/APHHS1005LQBC_D-V/Altium/APHHS1005LQBC_D-V.SchLib
Components/LIB_APHHS1005LQBC_D-V/APHHS1005LQBC_D-V/Altium/APHHS1005LQBCDV.PcbLib
Components/LIB_CY8C5868LTI-LP039/CY8C5868LTI-LP039/Altium/CY8C5868LTI-LP039.SchLib
Components/LIB_CY8C5868LTI-LP039/CY8C5868LTI-LP039/Altium/QFN40P800X800X100-69N-D.PcbLib
Components/LIB_ESD2CAN24DBZRQ1/ESD2CAN24DBZRQ1/Altium/ESD2CAN24DBZRQ1.SchLib
Components/LIB_ESD2CAN24DBZRQ1/ESD2CAN24DBZRQ1/Altium/SOT95P237X112-3N.PcbLib
Components/LIB_R7FA4M1AB3CFM#AA0/R7FA4M1AB3CFM#AA0/Altium/QFP50P1200X1200X170-64N.PcbLib
Components/LIB_R7FA4M1AB3CFM#AA0/R7FA4M1AB3CFM#AA0/Altium/R7FA4M1AB3CFM#AA0.SchLib
Components/LIB_TCAN332DR/TCAN332DR/Altium/SOIC127P600X175-8N.PcbLib
Components/LIB_TCAN332DR/TCAN332DR/Altium/TCAN332DR.SchLib
Components/LIB_TPS62086RLTR/TPS62086RLTR/Altium/TPS62086RLTR.PcbLib
Components/LIB_TPS62086RLTR/TPS62086RLTR/Altium/TPS62086RLTR.SchLib
Components/USB4105-GF-A/USB4105-GF-A/GCT_USB4105-GF-A.PcbLib
Components/USB4105-GF-A/USB4105-GF-A/USB4105-GF-A.SchLib
